Jamie215/HULC_motionshirt/firmware/MULTINODE_SYNC_MATH.md

# Multi-Node Sync & Reconciliation — Logic and Math

Companion to `MULTINODE_SYNC_DESIGN.md` (architecture/decisions). This document
records the **math and algorithm** behind time-aligning multiple IMU nodes, as
implemented in `tools/reconcile_nodes.py`. It is written so the method can be
reviewed, reproduced, and improved independently of the code.

> Equations use LaTeX (`$…$` inline, ` ```math ` display blocks), which renders
> on GitHub and in most Markdown viewers. Where a viewer does not render math,
> the symbols are still readable in source form.

---

## 1. The problem

Each node timestamps its samples with its own free-running `millis()` counter,
which starts at the node's power-on and ticks on its own crystal. For a physical
event at real time $\tau$, node $X$ records

```math
t_X(\tau) = \bigl(\tau - \text{boot}_X\bigr)\cdot 1000 \quad[\text{ms since node } X \text{ booted}]
```

Two nodes therefore disagree in two ways:

1. **Offset** — $\text{boot}_A \neq \text{boot}_B$, so their clocks have
   different origins.
2. **Drift (skew)** — their crystals tick at slightly different rates
   (tens of ppm), so the offset changes slowly over time.

"Reconciling" means finding, for each non-reference node $B$, a mapping onto the
reference node $A$'s timeline:

```math
t_{\text{on }A} = t_B + \text{offset} + \text{drift}\cdot\bigl(t_B - t_{B,0}\bigr) \quad (1)
```

where $\text{offset}$ (ms) and $\text{drift}$ (unitless rate, reported in ppm)
are what we must estimate. This is the **standard two-parameter clock model**
used by NTP, PTP, and distributed-systems clock synchronization.

The design constraint (see `MULTINODE_SYNC_DESIGN.md`): nodes are wireless and
analysis is offline, so we recover $\text{offset}/\text{drift}$ **from the
recorded motion itself**, independent of BLE latency.

---

> **Current default: the vector feature (§2.1).** Sections 2–4 describe the
> original angular-*speed* aligner, which is still the fallback
> (`--sync speed`). The default, `--sync vector`, correlates the full
> world-frame angular-velocity **vector** instead; §2.1 gives its math and
> acceptance rule. The offset/drift machinery (§3.1, §3.2, §5, §6) is shared.

## 2. The motion feature: angular speed (mounting-invariant)

Each node logs unit quaternions $q_i$ (orientation). Raw quaternions are **not**
comparable between nodes because each sensor is mounted at a different, unknown
orientation. So we reduce each stream to a scalar invariant to mounting:
**angular speed**, the magnitude of the rotation rate.

The rotation between consecutive orientations $q_i, q_{i+1}$ has angle

```math
\theta_i = 2\,\arccos\!\bigl(\lvert\, q_i \cdot q_{i+1}\,\rvert\bigr) \quad (2)
```

(the dot product is the quaternion inner product; the absolute value takes the
shorter arc, since $q$ and $-q$ are the same rotation). Angular speed is

```math
\omega_i = \frac{\theta_i}{\Delta t_i}, \qquad \Delta t_i = \frac{t_{i+1}-t_i}{1000} \quad (3)
```

**Why this works:** for a rigid body, angular velocity is a property of the body
(the same for every frame on it), so its magnitude $\lvert\omega\rvert$ is
identical regardless of how each sensor is bolted on. Two sensors on the same
moving segment therefore produce *correlated* angular-speed signals even though
their raw quaternions differ. (Implementation: `angular_speed()`.)

### 2.1 The default feature: world-frame angular-velocity vectors

Every node's Rotation Vector lives in the **same** world frame (gravity +
magnetic north), so the angular velocity can be expressed in that shared frame
rather than reduced to a magnitude. With $q_{i+1} = \Delta q_i \otimes q_i$,

```math
\Delta q_i = q_{i+1} \otimes q_i^{*}, \qquad
\boldsymbol\omega_i = \hat{\mathbf u}(\Delta q_i)\,\frac{2\arccos\lvert\Delta q_{i,w}\rvert}{\Delta t_i} \quad (3')
```

puts the increment in the world frame. A rigid segment has one world angular
velocity whatever its mounting, so two nodes that move together show the same
vector, **direction included** (`world_angular_velocity`). Each component is
resampled to the uniform grid and the three cross-correlations are summed, i.e.
the correlation of the vector signals is $\sum_k \boldsymbol\omega_A(k)\cdot\boldsymbol\omega_B(k+\ell)$.
The lag is the arg-max with the same parabolic refinement (§3.2).

**Acceptance.** Nodes on different segments (torso vs. arm) mostly move on their
own, so the overall normalised correlation $c$ (sum of dot products over the
overlap, divided by the two signals' norms) is low even when one shared sync
gesture pins the lag exactly. What matters is whether the best peak is
**distinct**:

```math
\rho = \frac{C(\hat\ell)}{\max_{\lvert \ell - \hat\ell\rvert > 0.5\,\text{s}} C(\ell)} \ \ge\ 1.25
\quad\text{and}\quad c \ge 0.10 \quad (9')
```

(`VECTOR_PEAK_RATIO_MIN`, `VECTOR_PEAK_EXCLUDE_S`, `VECTOR_CONFIDENCE_MIN`).
If either fails the aligner falls back to the speed method of §§2–4. The chosen
method and $\rho$ are written to `aligned.quality.json` as `sync_method` and
`sync_peak_ratio`. On synthetic torso + upper-arm sessions (`timing_bench.py`),
vector sync reaches the accuracy of a perfect-clock oracle where speed sync
failed.

---

## 3. Estimating the offset by cross-correlation

We have two angular-speed signals sampled at slightly different, jittered times.
Resample each onto a uniform grid at $f_s$ (default 100 Hz) in **relative** time
($t - t_0$), giving sequences $a[n]$ (node $A$) and $b[n]$ (node $B$) plus each
node's first timestamp $A_0, B_0$. (Implementation: `resample_uniform()`.)

The lag between the two sequences is found by **cross-correlation** (the classic
time-delay-estimation method):

```math
C[k] = \sum_n \bigl(a[n]-\bar a\bigr)\,\bigl(b[n-k]-\bar b\bigr) \quad (4)
```

```math
\hat k = \arg\max_k C[k], \qquad L = \frac{\hat k}{f_s}\ \ [\text{s}] \quad (5)
```

Positive $L$ means $a$ is delayed relative to $b$. (Implementation:
`_xcorr_full()` via FFT for $O(N\log N)$; `best_lag_seconds()` /
`lag_and_confidence()`.)

### 3.1 From relative-time lag to an absolute clock offset

The correlation is computed on **relative-time** signals, so $L$ alone is not
the clock offset — it must be combined with the difference of the nodes' start
timestamps. The two signals match when they sample the same real motion, i.e.

```math
\text{boot}_A + \frac{A_0 + s}{1000} \;=\; \text{boot}_B + \frac{B_0 + s - 1000L}{1000}
\quad \forall s
```

The $s$ terms cancel (a constant offset — the "no drift" case), leaving

```math
\bigl(\text{boot}_B - \text{boot}_A\bigr)\cdot 1000 \;=\; (A_0 - B_0) + 1000L
```

The left side is exactly the offset that maps $B$'s timestamps onto $A$'s clock
($t_A = t_B + \text{offset}$). Hence

```math
\boxed{\ \text{offset} = (A_0 - B_0) + 1000L \quad[\text{ms}]\ } \quad (6)
```

- $A_0 - B_0$ converts the relative-time result back to absolute clocks
  (bookkeeping).
- $L$ is the *measured* correction, read from the shared motion.

Equivalently, cross-correlating the two signals in **absolute** timestamps
directly yields $\text{offset}$; the code works in relative time only for
numerical convenience and adds $A_0 - B_0$ back.
(Implementation: `estimate_offset_drift()`.)

### 3.2 Sub-sample refinement (parabolic interpolation)

$C[k]$ is only evaluated at integer lags (10 ms apart at $f_s = 100$ Hz). The
true peak usually lies between samples, so we fit a parabola through the peak
sample and its two neighbours $y_{-1}, y_0, y_{+1}$
($= C[\hat k -1], C[\hat k], C[\hat k +1]$) and take its vertex:

```math
\delta = \tfrac{1}{2}\,\frac{y_{-1}-y_{+1}}{\,y_{-1}-2y_0+y_{+1}\,}, \qquad \delta\in[-\tfrac12,\tfrac12] \quad (7)
```

```math
L = \frac{\hat k + \delta}{f_s}
```

Near a smooth peak any function is locally quadratic (Taylor), so this is a
standard, well-justified refinement — it takes lag resolution from ~10 ms down
to ~1 ms. (Textbook DSP; used in spectral-peak and pitch estimation.)

---

## 4. Confidence — was there real shared motion?

$\arg\max$ always returns *a* peak, even for unrelated signals. So we separately
score whether the peak reflects genuine shared motion, using the **Pearson
correlation** of the two signals overlapped at the best lag:

```math
r = \mathrm{corr}\bigl(a_{\text{overlap}},\, b_{\text{overlap}}\bigr)\ \text{at lag }\hat k, \qquad r\in[-1,1] \quad (8)
```

Pearson is normalized (divided by each signal's standard deviation), so it
measures *shape* agreement independent of amplitude — a differently-swinging node
still scores high if it moved *together*. We accept the offset only when

```math
r \ge r_{\min} \quad (r_{\min} = 0.40) \quad (9)
```

Below that, the tool flags the result unreliable and the caller falls back to the
BLE clock-offset read and/or a start-of-session sync gesture.
(Implementation: `_pearson_at_lag()`.)

**Limitation this guards:** cross-correlation needs shared motion. Two nodes on
*independently* moving limbs (one arm swings, the other still) share nothing to
lock onto, and $r$ correctly drops toward 0. This is why a shared sync gesture is
the *primary* anchor and cross-correlation is a *refinement* (see
`MULTINODE_SYNC_DESIGN.md`).

---

## 5. Drift (clock skew) estimation

Drift is **off by default**: over a few-minute record, relative crystal drift is
only a few ms — below the measurement noise and negligible against the 25–50 ms
target — so fitting it adds noise. It is opt-in for long records.

When enabled, the lag is measured in $K$ windows spanning the record, giving
pairs $(t_j, L_j)$. A least-squares line $L = m\,t + c$ is fit; the slope $m$ is
the drift. It is accepted only if it is both statistically significant and large
enough to matter (the code constant `DRIFT_RESOLVE_MS` is written
$\varepsilon_{\min}$ below):

```math
\lvert m\rvert > 3\,\mathrm{SE}(m) \quad\text{AND}\quad \lvert m\rvert\cdot\bigl(t_{\text{last}}-t_{\text{first}}\bigr) > \varepsilon_{\min}\ (=15\text{ ms}) \quad (10)
```

Otherwise $\text{drift}=0$. Reported as `drift_ppm` $= m\times 10^6$.
(Implementation: `_windowed_lags()`, `_lsq_slope()`.)

Two guards keep the windowed lags honest (`_aligned_overlap`, `_windowed_lags`):
the windows are laid over the two nodes' **common** time span after applying
the global offset (so window $j$ of A and of B cover the same real time), and a
window is kept only if the two signals share motion in it (correlation
$\ge r_{\min}$). In a window where one node sits still, the "best" lag is
arbitrary; before this guard a trend fitted through such windows read a false
$+15.9$ s on a real capture. Fewer than 3 usable windows ⇒ no drift.

---

## 6. Applying the mapping and emitting aligned streams

With $\text{offset}$ (and optional $\text{drift}$), node $B$'s timestamps are
mapped onto $A$'s clock via Eq. (1) (`to_A_clock()`). A common uniform time grid
is built over the mutual overlap, and each node's **quaternions** are
interpolated onto it with normalized-linear interpolation (nlerp) along the
shorter arc:

```math
q(t) = \mathrm{normalize}\!\bigl((1-f)\,q_0 + f\,q_1\bigr), \qquad f = \frac{t - t_0}{t_1 - t_0} \quad (11)
```

(with a sign flip when $q_0\cdot q_1 < 0$). For 10 Hz human motion nlerp is
adequate; true SLERP could be substituted. The output is a CSV: one
`t_common_ms` column plus each node's $q_w,q_x,q_y,q_z$, ready for analysis.
(Implementation: `nlerp()`, `align_and_emit()`.)

---

## 7. Validation

`reconcile_nodes.py --selftest` generates two synthetic nodes from a shared
random motion with a **known** injected offset and drift, different mounting
rotations, sensor noise, and timing jitter, then checks recovery:

- recovered offset vs. the injected truth (target: within ~25–50 ms), and
- a **negative control** — a second node given *independent* motion must come
  back with low confidence and be flagged.

Current result: offset recovered to ~15–18 ms; shared-motion confidence
$r\approx 0.93$, independent-motion $r\approx 0.07$. This validates the *math* on
synthetic data; it is **not** a validation against hardware ground truth (§9).

---

## 8. Known limitations

- **Needs shared motion** (§4). Independent-limb captures require the sync
  gesture / BLE offset instead.
- **Linear clock model** (Eq. 1) — valid over minutes; a long session with
  temperature-driven crystal changes could need piecewise / periodic re-sync.
  See §11 for how a full-day capture is handled by tracking $\text{offset}(t)$
  as a fitted curve instead of a single global line.
- **Dropouts/gaps** in the logs degrade the correlation and inflate the residual
  (observed on real captures with intermittent recording).
- **Clock restarts.** A node that reboots mid-log (battery died) restarts
  `millis()` at 0, so one log holds two unrelated clocks. The loader splits at
  any backward jump over `CLOCK_RESET_MS` (1 s), keeps the largest segment,
  warns, and records `clock_restarts` in the quality JSON; the other pieces
  are not analysed. Offloading at every charge (one block per log) avoids it.
- **Speed fallback is a magnitude** — angular speed discards the rotation axis;
  two motions with identical speed profiles but different axes are
  indistinguishable to it. The default vector feature (§2.1) keeps the axis.

---

## 9. Algorithm / Technique Justification

The method is an assembly of **standard techniques** mentioned below:

- **Cross-correlation time-delay estimation** — the core. Classic reference:
  Knapp & Carter, *"The Generalized Correlation Method for Estimation of Time
  Delay,"* IEEE Trans. ASSP, 1976 (the GCC / GCC-PHAT foundation).
- **Aligning unsynchronized sensors by a shared signal** — standard practice in
  multi-camera/mocap/audio sync and multi-IMU synchronization (cross-correlate a
  common motion feature such as angular rate).
- **Offset + linear-skew clock model** — the standard model in NTP/PTP and
  sensor-network clock synchronization.
- **Parabolic peak interpolation** — textbook sub-sample estimation.

**Status:** Current implementation has **not** been benchmarked.

---

## 10. Upgrades for a rigorous / publishable result

1. **Ground-truth it** — feed a shared electrical sync pulse to a GPIO on all
   nodes, timestamp it in `millis()`, and report the *actual* alignment error in
   ms rather than a confidence score.
2. **GCC-PHAT** — whiten the cross-spectrum before the inverse FFT for a much
   sharper, more robust delay peak under noise and gaps.
3. **Robust fitting** — RANSAC or weighted least squares for offset/drift so
   dropouts don't skew the estimate.
4. **Richer feature** — correlate the full angular-velocity vector (rotated into
   a common frame after a coarse alignment) instead of only its magnitude, to
   break the axis-ambiguity of §8.

---

## 11. Long-session drift tracking: $\text{offset}(t)$ as a fitted curve

§5's single global line (one $\text{offset}$, one $\text{drift}$ for the whole
record) assumes the relative skew is **constant** across the capture. That holds
for a minutes-long record at stable temperature. It does **not** hold for a
full-day wear, where the skew itself drifts as body/ambient temperature moves the
crystals (§8). This section records the model that covers the long case, and
clarifies two points where the naming ("offset and drift") can mislead.

### 11.1 The model: one curve, sampled by events

There is a single underlying function

```math
\text{offset}(t) \quad [\text{ms}], \qquad \text{drift}(t) = \frac{d\,\text{offset}}{dt}
```

— the true clock difference between node $B$ and node $A$ at every instant, and
its local slope. Every shared-motion event (the don-time sync gesture of §3, or
incidental everyday motion, §11.2) is a **noisy sample** of this function:
cross-correlating the two nodes' motion windows (vector, or speed as fallback) around the event yields
one measurement $\bigl(t_j,\ \widehat{\text{offset}}_j\bigr)$ via Eq. (6), with a
confidence $r_j$ (Eq. 8). Reconciliation **reconstructs the curve** by
fitting/interpolating through these samples.

Two things the naming ("offset and drift") can obscure:

- **`offset` is absolute, not cumulative.** Each event measures
  $\text{offset}(t_j)$ directly and independently; you never add event $j{+}1$'s
  offset onto event $j$'s (that double-counts). The only thing that accumulates
  is *extrapolation error when you stop measuring* ($\approx
  \text{drift}\times\Delta t$) — the cost of a gap, not a property of the model.
- **`drift` is a slope, not a separate measurement.** It becomes observable only
  once samples are separated in time, which is why the don gesture (seconds long)
  gives a good `offset` but a poor `drift` — the lever arm is too short to clear
  the noise floor (`DRIFT_RESOLVE_MS`, Eq. 10). A single event's offset is noisy
  too, so you neither "trust it for $N$ minutes then jump" (which steps
  $\text{offset}(t)$ discontinuously and discards still-good samples) nor discard
  the prior estimate — you **fuse** (§11.2).

### 11.2 Getting the anchors, and combining them over time

**Where the samples come from.** They need not be deliberate. Over a day of wear
the body produces many **shared** events — standing up, starting to walk, turning
— each a fresh $\bigl(t_j, \widehat{\text{offset}}_j\bigr)$ measured by the *same*
machinery, with the confidence gate (Eq. 9) selecting which node-pairs each event
is valid for. Prefer **aperiodic transients** (sit→stand, turns); periodic motion
(steady walking) has the multi-peak lag ambiguity of §3/§4 and anchors poorly
even when shared. Participation is partial — an event re-anchors only the subset
of nodes that moved together, and different events cover different subsets, so
over a day it averages out. A node still for a long stretch isn't re-anchored, but
its signal is flat then, so the misalignment is harmless and *its next motion is
itself an anchoring event*.

**How the anchors combine.** There is no fixed validity duration; an old anchor
stays useful while its implied extrapolation error stays under budget, set by the
ratio of **process noise** (how fast $\text{drift}$ wanders — temperature
dynamics) to **measurement noise** (how tightly one event pins `offset`). Two
standard estimators carry $\bigl[\text{offset},\ \text{drift}\bigr]$ as a tracked
state rather than switching on a timer:

- **Sliding-window least squares** — fit a line to the $\bigl(t_j,
  \widehat{\text{offset}}_j\bigr)$ in a trailing window $W$, long enough for a
  good lever arm but short enough that drift is ~constant across it.
- **Kalman filter** — predict between events ($\text{offset}\mathrel{+}=
  \text{drift}\cdot\Delta t$; drift a slow random walk; covariance grows) and
  update at each event by the Kalman gain (confidence). Old data decays smoothly
  rather than being dropped, the process-noise parameter setting that forgetting
  time.

Either way a new event neither replaces nor adds to the prior estimate — the
estimate moves *partway* toward it, weighted by relative confidence. Drift moves
only with temperature, so anchors need not be frequent.

**Offline, most of this is moot.** "How long is a stale value good?" bites only
in real time, when all you have is the past. This pipeline is **post-hoc** — the
whole log is on the host at reconcile time — so for essentially any instant,
anchors bracket it on **both sides**. Evaluate $\text{offset}(t)$ by
**interpolating between the bracketing anchors** rather than extrapolating from a
stale one; the residual is far smaller. Extrapolation (and hence "validity
duration") only bites at the ends of the log, or inside a one-sided gap.

### 11.3 Where the code is, and the upgrade path

`reconcile_nodes.py` today fits the **single global line** of §5 — the simplest
point on this spectrum, correct for a minutes-long, stable-temperature capture.
Extending to full-day records means replacing that one line with the
**sliding-window fit or Kalman tracker** of §11.2, seeded by the don anchor and
fed by incidental events, then evaluated by interpolation. The per-event
measurement, confidence gate, and windowed-lag machinery all already exist
(`lag_and_confidence()`, `_windowed_lags()`, `_pearson_at_lag()`); what is new is
carrying `offset`/`drift` as a **tracked state over the whole log** instead of two
scalars. Robust fitting (§10.3) and GCC-PHAT (§10.2) compose with this directly —
they sharpen and de-weight the individual samples the tracker consumes.
