Jamie215/HULC_motionshirt/firmware/POWER_OPTIMIZATION.md

# Firmware Power Optimization

Power work on `firmware.ino`. This document tracks what has landed and 
the backlog of ideas still worth exploring, so nothing gets lost. Pre-optimization
baseline (from `IDLE_WAKE_SOURCE.md`): ~12 mA IDLE (DETECTOR), ~22 mA ACTIVE 
recording (full fusion).

## Landed

These are in the firmware now. None change the recorded data format or the state
machine's logic; each is commented at its site.

1. **DC/DC regulator enabled** — `NRF_POWER->DCDCEN = 1` at the top of `setup()`.
   Switches the nRF52840's main supply from the default LDO to the internal buck
   converter (the XIAO populates the REG1 inductor). More efficient in every
   state, most of all with the radio active. Board-wide; a large part of the
   measured idle and active drop (see Measured results).

2. **BLE advertising made cheap and IDLE-only.**
   - Advertising interval slowed to ~1 s (`ADV_INTERVAL_UNITS = 1600`, units of
     0.625 ms) — cuts advertising radio-on time ~10× vs the fast default. Offload
     is occasional and IDLE-only, so ~1 s discovery latency is fine.
   - Advertising is **gated to IDLE**: `applyPendingTransition()` re-advertises on
     IDLE entry and calls `stopAdvertise()` entering the RUNNING states; the
     disconnect handler only re-advertises when in IDLE. Offload is rejected
     outside IDLE anyway, so advertising while recording bought nothing and spent
     radio power at the IMU's peak draw.

3. **Report rate matched to log rate (Tier A).** `BNO_RV_INTERVAL_MS` 65 ms
   (~15 Hz) → 100 ms (10 Hz). The BNO no longer computes and ships ~5 fusion
   samples/sec that ACTIVE's `activeHz` gate discarded (each a wasted I²C read +
   nRF wake). Also drops STATIC_POSTURE (shared config, logs only 0.2 Hz) from
   ~15 Hz to 10 Hz. No change to recorded data.

4. **Game Rotation Vector A/B switch** — `ACTIVE_FUSION_SOURCE` (Section 3b),
   defaulting to `ACTIVE_FUSION_RV` so behavior is unchanged until flipped.
   `ACTIVE_FUSION_GRV` selects the 6-axis Game Rotation Vector (no magnetometer):
   no mag calibration, immune to magnetic interference from batteries / other
   on-body nodes / metal; the cost is slow yaw drift (pitch and roll stay solid).
   The 20-byte record format is identical, so nothing downstream changes.
   **Bench-measured: GRV gives no meaningful power saving vs RV** (see Measured
   results) — the gyro + fusion engine dominate, the magnetometer is cheap. So
   **decide GRV purely on data quality**, not power: keep the default RV unless a
   run of captured orientation data shows magnetometer-driven heading corruption
   (likely once multiple nodes + batteries sit close together on the body), in
   which case GRV trades absolute heading for cleaner, interference-free
   orientation. When building the GRV path, compile-check it against the installed
   SparkFun library version (the `getGameQuat*` getter names follow the current
   API but were not compiled here).

5. **External flash deep power-down during IDLE.** `qspiSleep()` puts the P25Q16H
   into deep power-down (`0xB9`) whenever the node sits in unconnected IDLE (which
   never touches flash); `qspiWake()` releases it (`0xAB`) before any access — on
   BLE connect (offload/erase arrive as control commands), at the top of
   `applyPendingTransition()` for the header write, and at end of `setup()`;
   re-park on IDLE entry and on disconnect back into IDLE. **Saving is small** —
   serial-NOR standby is ~tens of µA against the ~9 mA idle, below meter
   resolution — so don't expect the idle figure to move; this is completeness,
   not a lever.

   **Tried and reverted: nRF QSPI *peripheral* deactivation.** Also deactivating
   the nRF's QSPI peripheral (`nrfx_qspi_uninit()` on sleep, re-init on wake) was
   implemented and bench-tested, and it made idle **WORSE — ~9 mA → ~11 mA**.
   Cause: **nRF52840 Errata 122, "QSPI uses current after being disabled"** — a
   *disabled* QSPI peripheral leaks ~1–2 mA unless Nordic's errata workaround (an
   extra write to an undocumented power register) is applied, and the Seeed mbed
   core's nrfx does not apply it. So `nrfx_qspi_uninit()` handed us the leak, not
   a saving. **That code was removed** for readability; only the harmless chip
   deep-power-down above remains. If ever revisited, the peripheral disable must
   be paired with the Errata 122 register workaround and re-measured — but idle
   here is dominated by the BNO hub (~8 mA), so the ceiling on any QSPI-side win
   is small regardless.

6. **Tier B: STATIC-specific slow RV.** The RUNNING config is no longer shared
   at one rate — `configureBNO_Running()` now takes a `BnoRunningCfg`
   (`BNO_CFG_ACTIVE` / `BNO_CFG_STATIC`) and STATIC arms the fusion vector at
   `BNO_RV_STATIC_INTERVAL_MS` (1000 ms, ~1 Hz) instead of the ACTIVE 100 ms
   (~10 Hz). STATIC logs only 0.2 Hz, so even the Tier A 10 Hz RV shipped ~50
   reports per logged sample — each a wasted I²C read + nRF wake; ~1 Hz cuts
   those RV wakeups ~10× while still giving 5 orientation samples per logged
   snapshot (a logged posture is at most ~1 s stale, negligible for a static
   hold). **The Classifier is untouched — it keeps running at
   `ACTIVE_STABILITY_MS` (500 ms) in both RUNNING states, so it (not the RV)
   still drives every transition and motion detection out of STATIC is
   unchanged.** No change to the recorded data format or the 0.2 Hz log rate.

   Structural notes (this was the "needs careful validation" backlog item):
   - The old `bnoInRunningMode` bool couldn't tell an ACTIVE↔STATIC switch (rate
     must change) from a same-state re-entry (skip). It's replaced by the
     `BnoRunningCfg` enum (`NONE`/`ACTIVE`/`STATIC`), so same-state re-entry is
     still skipped, a fresh entry from IDLE / post-reset (`NONE`) enables *both*
     reports, and an ACTIVE↔STATIC switch re-issues *only* the fusion vector at
     the new rate — the fewest `enableReport`s, to stay off the command-buffer /
     premature-reset path (SparkFun issue #2). The `delay(50)` ack guard is kept.
   - The enum type lives in Section 10 (with `SystemState`), ahead of the first
     function, so the Arduino auto-generated prototype for the now-typed
     `configureBNO_Running(BnoRunningCfg)` sees it defined.
   - The classifier-floor point: because the Classifier still wakes the nRF at
     ~2 Hz in STATIC, the STATIC wake rate drops from ~12 Hz (10 RV + 2 clf) to
     ~3 Hz (1 RV + 2 clf) — a ~4× cut in nRF wakeups, not the full 10× the RV
     alone changes by. Taking the RV below the classifier's 2 Hz would buy little.

7. **IDLE wake source — DETECTOR (default), CLASSIFIER, SIGMOTION.** Three
   selectable wake sources (Section 3). Measured on the optimized build:

   | Source | Idle | Self-reset | Catches slow held-limb motion? |
   |---|---|---|---|
   | Stability Detector (default) | ~8.8 mA | ~6.7 s (benign) | Yes |
   | Significant Motion | ~7.4 mA | none | No — energetic motion only |
   | Stability Classifier | higher (gyro) | none | Yes |

   **DETECTOR is the default** because it reliably wakes on slow, deliberate
   motion (held-limb stretches). **SIGMOTION idles ~1.4 mA lower** — as a one-shot
   event it does not run the detector's ~6.7 s self-reset — **but it only fires on
   energetic motion (shake/pickup) and misses slow stretches** (it is an
   energy-over-a-window detector; its accel threshold + window are tunable via the
   FRS record `SIG_MOTION_DETECT_CONFIG` (0xC274) but the SparkFun library exposes
   no FRS-write path, so we cannot set it today — see `IDLE_WAKE_SOURCE.md`).
   So SIGMOTION suits only cases where slow-motion wake latency is acceptable
   (e.g. off-body standby), not on-body capture. CLASSIFIER also avoids the reset
   but runs the gyro/MotionEngine at higher idle current.

   The ~1.4 mA detector↔SIGMOTION gap is the self-reset cycle. That reset is
   inherent to a non-fusion continuous sensor, is unaffected by report rate, and
   is only removed by running the fusion engine (the classifier's cost) — so
   **~8.8 mA is the detector's floor for slow-motion capture**; going lower while
   keeping that capture needs a hardware wake (see the last backlog item). At the
   chip level the datasheet (Fig 6-18) puts the SIGMOTION sensor above the detector
   (~0.48 mA vs ~0.06 mA); SIGMOTION is still lower at the node level purely
   because it avoids the reset.

8. **Detector reported on-change (no ~1 Hz heartbeat).** The Stability Detector
   fires EXITED the instant motion breaks stability regardless of its report
   interval, so `IDLE_DETECTOR_INTERVAL_MS` is set long (60 s keepalive) and the
   detector stays silent while still instead of waking the nRF ~1×/s. Measured
   ~0.2 mA idle trim, with the ~6.7 s self-reset cadence and slow-motion
   sensitivity both unchanged. `handleIdle()` logs ms-since-last-reset as a field
   diagnostic of that cadence.

## Backlog — worth exploring

Ordered roughly by payoff. Each needs bench time or a design decision, so they
were deliberately left out of the safe batch above.

- **Reconfigure BNO rate on watermark throttle.** When flash fills,
  `writeQuaternionSample()` halves `activeHz` (10→5→2), but that only changes the
  software gate — the BNO keeps emitting 10 Hz, so the throttle saves flash but
  not IMU/nRF power. Reconfiguring the RV report rate when `activeHz` changes
  would capture the power saving too. Now cheaper to do safely: Landed item 6
  (Tier B) added the per-transition fusion-only reconfigure path
  (`configureBNO_Running(BnoRunningCfg)`), so this could re-issue just the fusion
  vector at the throttled rate the same way (mind the same SparkFun issue #2
  re-issue caution).

- **QSPI peripheral deactivation — tried, backfired, removed (see item 5).**
  Measured ~9 → ~11 mA idle from nRF52840 Errata 122; the code was removed. Only
  worth revisiting with the Errata 122 register workaround applied after the
  disable, and even then the BNO-dominated idle caps the win — low priority.

- **Sleep instead of spin while connected-idle.** In `waitForIMUData()`, the
  BLE-connected branch busy-loops on `BLE.poll()` for up to 100 ms with no sleep,
  so the core never idles while a central is connected. A `__WFE()` between polls
  would let it sleep between radio/BNO events. Relatedly, the fast 15–30 ms
  connection interval is held for the whole connection but only needed during
  offload — relaxing it except around a transfer cuts connected-idle radio
  wakeups.

- **Production build: drop USB/serial.** `DEBUG_SERIAL 1` keeps USB CDC (and
  HFCLK) alive. Note the `Serial.print`/`Serial.begin` calls in the QSPI helpers
  and `setup()` are **not** behind the macro, so `DEBUG_SERIAL 0` alone doesn't
  fully shed USB. Gate those too for a deployed build to remove the USB draw.

- **fsync tuning.** `FSYNC_EVERY = 10` does a 4 KB sector erase + write + readback
  every ~1 s at 10 Hz — erases are power-hungry and wear flash. Raising it trades
  a little more data-at-risk on power cut for fewer erases; the readback verify
  could also be made less frequent.

- **LEDs (hardware).** The SparkFun BNO086 breakout's red LED and the XIAO
  nRF52840's own power LED are **power indicators wired to the 3.3 V rail, not
  GPIOs** — not firmware-controllable. Disable by cutting the board's `LED`
  solder jumper (per node, reversible). ~1–3 mA each, on 24/7. Worth doing on
  every deployed node. In firmware, the blue "connected" LED (`PIN_LED_BLUE`) is
  held on for the whole connection — could be dropped or briefly blinked during
  long offloads.

- **Below the detector's slow-motion floor needs hardware.** With the detector
  (the only wake source that catches slow held-limb motion), idle floors at
  ~8.8 mA — the remaining ~1.4 mA to SIGMOTION's ~7.4 mA is the detector's
  inherent ~6.7 s self-reset, which only running the fusion engine removes (at
  higher current) and which no report-rate change affects. Going lower while
  keeping slow-motion capture would need a separate low-power motion sensor with
  its own interrupt waking the nRF, which then powers the BNO — a hardware change,
  out of scope for firmware alone.
