Jamie215/HULC_motionshirt/hardware/HULC_MS_Wearable_Case.step

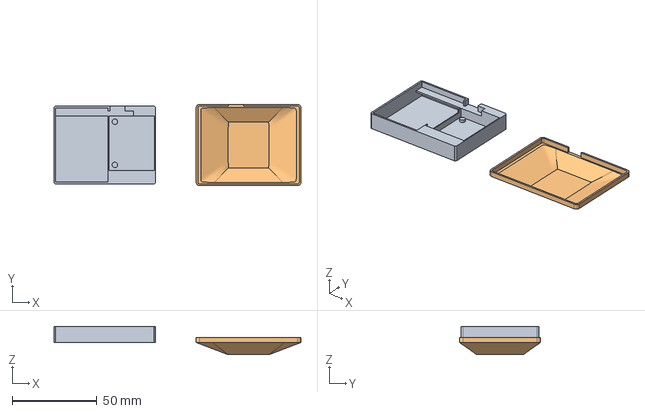
[picture p9: CAD file, 2026-10-29]
hardware/HULC_MS_Wearable_Case.step
146.0 x 48.0 x 16.7 mm
