Jamie215/HULC_motionshirt/firmware/MULTINODE_TESTING.md

# Multi-Node BLE Sync Testing

This document covers testing the **synced BLE connection across multiple IMU
nodes** — the step after the single-node Phase 3e firmware. A motion shirt uses
several IMUs (one per body segment); their quaternion streams are only fusable
if all nodes share a common time base to within a few milliseconds.

## What changed in the firmware for multi-node

| Change | Where | Why |
|---|---|---|
| **Unique per-board name** `HULC-IMU-XXXX` | `makeDeviceName()` | All boards used to advertise `HULC-IMU-01` and collide. The suffix is the last 4 hex chars of the board's BLE MAC, so it is stable per board with no per-board reflash (and needs no nRF MDK headers). |
| **Millisecond time sync** (control cmd `0x05`) | `handleControl()` | The legacy sync (`0x02`) carried a whole-**second** epoch — far too coarse to align nodes. `0x05` carries a `uint64` epoch in **ms**. |
| **Time Info characteristic** `A005` (read, 16 B) | `updateSyncInfo()` / `onSyncInfoRead()` | Lets the central read each node's live clock and reconstruct its epoch-now, so cross-node offset can be measured. Refreshed on every read. |
| **Fast connection interval** (7.5–15 ms) | `setup()` `BLE.setConnectionInterval(6,12)` | The first 2-node run showed A005 reads taking 300–800 ms, which floored offset measurement. Requesting a tight interval drops GATT read latency so the offset becomes meaningful. The central may clamp it — it is a request, not a guarantee. |

The legacy `0x02` (seconds) command still works and now also populates the ms
mapping, so nothing downstream breaks.

### A005 layout (little-endian)

| Bytes | Type | Field |
|---|---|---|
| 0–3 | uint32 | node `millis()` at the moment of the read (live) |
| 4–11 | uint64 | sync epoch in ms (0 if never synced) |
| 12–15 | uint32 | node `millis()` captured at the last sync |

The central computes each node's current epoch as:

```
node_epoch_now_ms = sync_epoch_ms + (node_millis_now - sync_millis)
```

and compares two nodes to get their clock offset (the host term cancels).

## Test setup (laptop harness, 2 boards)

1. Flash the firmware to **both** XIAO nRF52840 boards from `firmware/firmware.ino`.
   No per-board edits — each derives its own name from its BLE MAC.
2. Power both boards. Confirm over serial that each prints a **distinct**
   `[BLE] Advertising as HULC-IMU-XXXX`.
3. On the laptop:
   ```bash
   pip install bleak
   python tools/multinode_test.py check --count 2 --duration 60
   ```

The harness scans, connects to both nodes simultaneously, syncs each with an
ms-resolution timestamp, then reads `A005` from both in a round-robin for the
duration and reports the cross-node offset and its drift.

The tool uses subcommands (`check`, `erase`, `offload`, `enroll`,
`read-segments`, `selftest`); the older flag form (`--offload`, `--erase`, …)
was retired.

Other modes:
* `check --count 1` — single-node latency diagnostic (isolates per-link latency
  from multi-connection scheduling).
* `offload` — offload each node's flash log to a `.bin` (and measure throughput
  KB/s), with a `.seg.json` segment sidecar per node and the block's
  `montage.json` built from them. The transfer is now framed and loss-verified —
  see below.
* `enroll --segments ...` — map each board to a body segment (power one node at a
  time) and write `montage.json`; see `docs/COLLECTION_REFERENCE.md` §4.

## Flash offload — framing & drop recovery

(The protocol a central follows — commands, framing, recovery — is written out
for a mobile app in `docs/BLE_PROTOCOL.md`.)

The offload streams the flash log over the `A004` characteristic as BLE
**notifications**, which are **unacknowledged**: if the central's stack drops
one (common on Windows/WinRT under a fast burst), that packet is gone and
neither side is told. Because each packet carried 10 back-to-back records
(200 bytes ÷ 20), a single dropped notification silently deletes a 10-record
run from the *middle* of the reconstructed file, and the records on either side
become adjacent — showing up downstream as a multi-second **gap** with clean,
valid records on both sides. The tell: gap durations are exact multiples of one
chunk (~1.2 s = 10 records), independent per node, with nothing in the device's
serial (the recording never gapped — only the transfer lost data).

To make loss **detectable and recoverable**, every notification is framed:

| Bytes | Field |
|---|---|
| 0–3 | `uint32` LE **offset** of this payload within the log data region |
| 4… | up to `OFFLOAD_DATA_SIZE` (196) bytes of record data |

A **header** notification is sent first with a sentinel offset
(`0xFFFFFFFF`) whose payload is the exact total log length. Framing stays within
the existing 200-byte notification, so no MTU change is needed.

The host (`measure_offload`) places each payload by its offset, so a dropped
notification leaves a **locatable hole** instead of a collapsed gap. Recovery
has two parts, both leaning on the fact that the node does **not** erase until it
receives `0x03`:

1. **Backpressure (firmware).** `offloadChar.writeValue()` returns false when the
   BLE TX buffer is full; the sender now retries the same notification (pumping
   `BLE.poll()`) instead of advancing, so it self-paces to the negotiated
   connection interval rather than blasting every 3 ms and overflowing. Without
   this the sender alone dropped ~45% of notifications.
2. **Targeted range re-request (control `0x06`).** After a first full pass
   (which also delivers the header total), the host re-requests **only the
   missing byte ranges** — `[0x06, offset u32 LE, length u32 LE]` → the firmware
   re-sends just those bytes with the same framing. A whole-log re-offload
   recreates the same fast burst and tends to drop the *same* chunk every pass
   (deterministic central-side loss that merging can never fill); a small,
   non-bursty range resend does not, so it recovers those holes. Repeats up to
   `OFFLOAD_MAX_ATTEMPTS` (4) times until the bytes match the header total.

Reading the output:

* `pass 1 (full): 3528/5300 bytes, 5 hole(s)` → drops detected and located.
* `pass 2: re-requesting 5 range(s)...` → targeted recovery.
* `COMPLETE — saved N bytes (M records) -> file.bin` → verified whole; safe to
  reconcile.
* `[!] INCOMPLETE after 4 attempts …` → still missing after all retries. The
  file is saved with holes **zero-filled** (reconcile drops zero-norm records,
  so survivors keep their true timestamps rather than collapsing into a fake,
  undetectable gap), and a warning lists the missing offsets. Re-run `offload`
  to recover the rest (the log is still on the node).

If a particular central drops heavily, raise `OFFLOAD_MAX_ATTEMPTS`, or switch
to a non-Windows central (below) — the same platform choice that governs
throughput also governs drop rate.

### Flash hygiene — erase between sessions

The write pointer persists across reboots (it's saved in the flash header), so
if you **power-cycle a node without erasing**, the next recording is *appended*
to the old one. `millis()` resets to ~0 on boot, so the log then holds two
sessions with a large backward timestamp jump at the seam. `reconcile_nodes.py`
keeps the strictly-increasing run and drops the rest — you'll see a
`dropped N/M bad records (… non-monotonic)` warning. It's harmless to the
analysis but means stale data is accumulating.

Keep each node's flash to a single session:

* **`offload --erase-after`** — wipe each node's flash **only after its
  offload is verified `COMPLETE`**, so you never erase data you didn't fully
  receive. This is the clean default workflow: offload, verify, wipe.
* **`erase`** — wipe each node that holds data (`--yes` skips the per-node
  confirm), then exit (use before a capture, or to
  clear a node you don't need to offload).

`eraseLog()` erases the whole chip in 64 KB blocks and **verifies the data region
reads back blank (0xFF) before resetting the write pointer**, so a silently
failed erase leaves the log intact and still reported at its real size rather
than falsely showing `log=0KB`.

## Offline reconciliation (`tools/reconcile_nodes.py`)

Aligns the offloaded per-node quaternion logs onto one common timeline by
cross-correlating the motion itself (world-frame angular-velocity vectors by
default, `--sync speed` for the older angular-speed method), so it recovers the
clock offset from the data — no dependence on BLE read latency. This is the
production sync path (see `MULTINODE_SYNC_DESIGN.md`).

```bash
pip install numpy
python tools/reconcile_nodes.py --selftest          # validate the math, no HW
python tools/reconcile_nodes.py A.bin B.bin --out aligned.csv   # real logs
```

The `--selftest` recovers a known injected offset to ~15–18 ms (inside the
25–50 ms target). For real use, offload each node's log to a file of raw 20-byte
records and pass them in node order (the first is the reference clock).

**Central platform matters.** A slow negotiated connection interval floors both
read latency and offload throughput. Desktop Windows (via `bleak`) tends to
impose a slow interval; iOS/BlueZ honor the firmware's 15–30 ms request.
Testing from a non-Windows central:
* **iPhone** (*nRF Connect for Mobile*) — iOS hides the connection interval from
  apps, so judge it by *behavior*: enable notifications on `A004`, write `04` to
  the Control char `A002` to start the offload, then **read the node's USB
  serial monitor** for the `[OFFLOAD] Done` line. The firmware measures the real
  wall-clock transfer time and prints throughput (KB/s) and **ms/chunk** — and
  because one notification goes out per connection event, ms/chunk ≈ the
  effective connection interval the central negotiated (the number iOS won't
  tell you directly). This is the most reliable way to measure offload speed on
  any central.
* **Mac** — run `multinode_test.py offload` (`bleak` works over CoreBluetooth)
  for a hard KB/s number, directly comparable to the Windows run.
* **Android** nRF Connect *does* display the negotiated interval directly.

See `MULTINODE_SYNC_DESIGN.md` for the full rationale.

## How to read the results

* **CONNECT** — both nodes should report connected and *stay* connected. A node
  that is connected no longer advertises; if the harness can't find the second
  node, make sure it isn't already connected to something else (e.g. a phone).
* **read window** (per node) — how long each `A005` read took round-trip. This
  is the **measurement floor**: the node's clock is only known to within its
  read window. Bench observation is ~300–800 ms with two simultaneous
  connections, because the firmware services BLE in ~100 ms bursts in IDLE
  (`waitForIMUData`) and does not request a fast connection interval. Until this
  drops, offset cannot be measured to better than a few hundred ms.
* **offset** — reported as a value **± the read-window bound**. Treat it as an
  *upper bound* on the true offset, not a calibrated number. A result like
  "±300 ms" means only that the nodes are aligned to within a few hundred ms —
  it does **not** confirm ms-level sync.
* **drift** — the harness prints `NOT RESOLVABLE` whenever the measured slope is
  below the read-latency noise floor. Real relative crystal drift between two
  nRF52840s is tens of ppm → single-digit ms/min, which is far below that floor,
  so a large or negative "drift" from a noisy run is a **measurement artifact**,
  not physical clock behavior.

**Bottom line:** this method validates *connectivity and the sync path*, but the
BLE read latency makes it unable to confirm ms-level alignment. For that, reduce
the read latency (firmware: fast connection interval + continuous BLE servicing
when connected) and/or use a shared physical event (below).

## Known limitations / next steps

* **Sync precision is bounded by BLE write latency.** `0x05` is issued per node
  over its own connection, so each node's sync moment carries that node's write
  latency (a few ms, variable). For tighter alignment consider: a round-trip
  (NTP-style) estimate that measures and subtracts the one-way delay, or
  periodic re-sync to cancel accumulated drift.
* **No shared physical event yet.** The offset here is a software estimate. To
  ground-truth it, tap all nodes together (a shared impulse in the accel data)
  and compare the recorded timestamps of that event across nodes.
* **Connection count.** Two nodes is the current bench target; the nRF SoftDevice
  and the host adapter both cap simultaneous connections — validate the real
  ceiling before scaling to a full-shirt node count.
