Jamie215/HULC_motionshirt/tools/SETUP_AND_CALIBRATION_PLAN.md

# Setup & Calibration — Design Plan (pipeline stages 5–7)

Planning doc for the later stages of the analysis pipeline, and the record of the
design decisions behind them. Stages 1–4 (capture → offload → reconcile →
montage/resolve) exist in `firmware/` and `tools/`; **stage 5 (calibration) is now
built** — `calibrate_segments.py` implements §4 below (the sensor→segment solve
with the cache-and-verify contract). This doc covers stage 5 and what still comes
after, in build order:

- **§2 Configuration & node identity** — how a node knows/records where it is.
- **§3 Time offset vs. mounting calibration** — two different quantities, two
  different lifetimes. The single most important distinction here.
- **§4 Calibration (stage 5)** — the sensor→segment solve, cache-and-verify.
- **§5 Free-body diagram (part of stage 7)** — the natural visual payoff.

See `pipeline_walkthrough.html` for the whole pipeline at a glance, and
`MONTAGE_SCHEMA.md` for the montage/resolver already built.

---

## 1. Anchor facts (from the firmware, not assumptions)

- Nodes log the **full Rotation Vector** (`enableRotationVector()` → report
  `0x05`), which is **magnetometer-referenced**. Every node's orientation is
  therefore already in a **shared world frame** (gravity + magnetic north), not
  the arbitrary per-node heading a Game Rotation Vector would give.
- Each sample is timestamped with the node's free-running **`millis()`**, which
  starts at zero on **power-up**. There is no persistent real-time clock.
- Nodes advertise a unique identity `HULC-IMU-XXXX` (from the BLE MAC); the
  offloaded file is named by it.

These three facts drive everything below.

---

## 2. Configuration & node identity

**Decision: separate "which node is where" (config) from "how the sensor sits on
the bone" (calibration).** They have different lifetimes (config is stable across
wears if sensors live in fixed garment pockets; calibration is per-don), so they
are different artifacts, not one step.

### 2.1 Persist the segment assignment on the node

> **Built.** `firmware/firmware.ino` stores the segment as a 1-byte code plus a
> config-valid tag in the log header's reserved bytes (persists across power
> cycles and log erases); it is set over BLE with control `0x07` and reported on
> the status characteristic. The code enum is pinned in
> `motion_capabilities.SEGMENT_CODES` (the one source of truth). Host side:
> `multinode_test.py` `set_segment` / `read-segments`, the `.seg.json` offload
> sidecar, and the `analyze_session` disagreement warning.

**Decision: store the segment as a 1-byte enum in a per-log *header*, not per
record, and not as a string.**

- Per-record would waste flash; a single header field per session is negligible
  against a 2 MB flash of 20-byte records. The "abbreviate to save space" worry
  only existed under a per-record assumption.
- A `uint8` segment code (`0=torso, 1=upper_arm_l, 2=upper_arm_r, …`) costs one
  byte. It makes the **offloaded file self-describing** — the file already says
  *which node*; the header adds *which body part* — which removes the
  mislabel-after-offload risk.
- Source-of-truth rule: the node header is the **default**, a host montage may
  **override**, and reconcile **warns on disagreement** (same pattern as the
  landmark check). Better: **auto-populate the montage from the headers** so it
  stops being hand-typed and the user only confirms.

### 2.2 The configuration stage (front end of montage + calibration)

The montage **is** the configuration; the config stage is the setup UX that
produces it. Fold three things into one "don the shirt" flow:

1. **Assign** each node to a location (writes/confirms the montage; may write the
   assignment to the node per §2.1).
2. **Verify placement** live via the free-body diagram (§5) — a mislabeled or
   slipped node is visible immediately.
3. **Calibrate** — strike the neutral pose (§4).

**Optional upgrade — auto-assignment.** Because nodes report absolute
orientation, a scripted setup ("raise your right arm") can detect *which node
moved* and assign it automatically, turning the error-prone manual mapping into
confirmation. Prototype after the manual path works.

### 2.3 Constrained, repeatable placement (why it helps)

**The mounting offset does not need the sensor aligned to anatomy — only placed
the same way each wear.** Two consequences worth designing the garment around:

- **Anatomical tilt is absorbed, not fought.** A chest node lies flat on the
  sternum, which slopes back with the ribcage, so it sits at a fixed angle to the
  true trunk axis. That fixed angle *is* the mounting offset — the neutral pose
  defines it away. The same holds for any arm node. So placement need not be
  "aligned"; it needs to be **repeatable**, because a repeatable offset is what
  lets `verify` reuse a cached calibration instead of re-posing every don (this is
  the "better mounting" rung of the §4 ladder).
- **Control the axial roll.** The most fragile degree of freedom for an arm node
  is rotation *around* the limb (it corrupts pronation/supination and int/ext
  rotation — see the elbow caveat in `MONTAGE_SCHEMA.md` §3). Fixing each arm
  sensor to a consistent flat spot (e.g. a sagittal-plane pocket referenced to a
  bony landmark, not just "somewhere on the segment") pins that roll down; the
  neutral pose then handles the two easier tilt axes. This constrains placement
  but **does not change the solve** — it just makes it better-conditioned and more
  repeatable, so keep solving all three axes rather than hard-coding any.

---

## 3. Time offset vs. mounting calibration (the key distinction)

Two quantities are refreshed at the start of a wear. They are **independent** and
must not be conflated:

| | Aligns | Invalidated by | Cacheable? | Refreshed how |
|---|---|---|---|---|
| **Time offset** | the nodes' clocks (temporal) | every **power-up** | **No** | automatic BLE clock read at connect, or a shared sync gesture |
| **Mounting calibration** | sensor→segment (spatial) | every **re-don** | **Yes** | a ~2 s neutral pose, or reuse-if-verified |

- **Time offset cannot be cached.** Each node's `millis()` restarts at zero on
  boot, so a previous session's offset is meaningless after a power cycle. It is
  re-anchored every session — but on a well-behaved central this is *automatic*
  (the BLE clock-offset read needs no user action). Within a session it holds
  (drift negligible over minutes).
- **Mounting calibration survives a power cycle** (it is a physical relationship,
  not a clock) and is broken only by physically re-wearing the garment — so it
  *can* be cached and verified.
- A charge-then-rewear trips **both**, for different reasons (the power cycle
  resets clocks; the re-don shifts straps). That coincidence is why bundling them
  into one session-start step is convenient — not extra burden, since the
  session-start moment already exists for timing.

**Correction this supersedes:** the sync gesture is per-*session*, not
once-forever. "Once at the beginning" means the beginning of each wear/session,
because power-up resets the clocks.

---

## 4. Calibration (stage 5) — the sensor→segment solve

> **Built:** `calibrate_segments.py` (`calibrate` / `verify` / `selftest`). It
> reads the reconcile `aligned.csv` + a montage, solves the per-segment mounting
> offset over the neutral-pose window, and emits `calibration.json` with the
> consistency baseline. `verify` runs the reuse-vs-re-pose check below against a
> cached calibration. Anatomy (segments, joint adjacency) is imported from
> `motion_capabilities.py` so there is one body model.

**In plain terms.** A sensor is like a compass strapped to the arm at some unknown
angle: it always reports honestly in a fixed world frame (gravity + magnetic
north), but a crooked strap means its reading is not yet *about the bone*. The one
unknown is that crookedness — the fixed rotation between sensor and bone. To find
it, we use a pose whose answer we already know: the subject stands in the neutral
pose, we declare that configuration to be zero, and whatever the sensor reads there
*is* the correction. Store it once; subtract it from every later reading, and the
numbers become anatomical. A joint angle is then just one corrected sensor relative
to its neighbour (upper-arm vs. torso = shoulder), which reads zero at the neutral
pose as it should.

**What it computes:** the mounting offset for each node — the rotation from the
sensor's frame to its segment's anatomical frame. The mag-referenced world frame
is *given*, so this is a sensor-to-segment calibration, **not** a "resting
quaternion" capture. See `MONTAGE_SCHEMA.md` §4 for the three jobs the neutral
pose does (solve offset, set zero, heading co-registration fallback).

**Cache-and-verify contract (decided).** The stage-5 routine emits **both**:

1. the per-segment mounting offset (→ `calibration.json`), and
2. a **staleness / consistency check** — enough to decide, on the next don,
   *reuse vs. re-pose*: during the first still moment, test whether the cached
   offsets are still self-consistent in the shared world frame (e.g. calibrated
   segment axes still point where a quiet-standing pose implies). Small residual
   → reuse silently; over threshold → prompt for a fresh ~2 s pose. The same
   check catches **intra-session slippage**, not just re-dons.

**Cheapening ladder** (build 1–2 first; 3–4 later):

1. **Fold into the session-start move** you already do for timing — the pose *is*
   the calibration, not a separate chore.
2. **Cache + verify** (above) — the "feels like skipping" path.
3. **Functional / auto-calibration from motion** — recover the offset from a
   short bout of ordinary movement (gravity gives vertical; a joint's gyro axis
   gives the hinge), removing the deliberate pose. More algorithm; needs each
   joint to move.
4. **Better mounting** (rigid, anatomically-shaped pockets) shrinks don-to-don
   variation, widening how often #2 can reuse before a re-pose.

**Emits:** `calibration.json` — per-segment offset + captured window + the
consistency baseline. Gates every angle/ROM metric; flips the resolver's
`calibrated` flags from relative-only to clinical.

---

## 5. Free-body diagram (part of stage 7) — feasibility

> **Built (`skeleton_viewer.py`, `render` / `selftest`).** Bakes the reconcile
> stream + an optional `calibration.json` into a single self-contained HTML
> viewer (no external scripts/CDN — a hand-rolled Canvas-2D 3-D renderer, works
> offline and straight from `file://`), with a **raw↔calibrated toggle**
> (applies `q_seg = q_WS ⊗ q_SB` in the viewer) and **jump-to-neutral**. (An
> earlier *Floating* layout — each segment an oriented bar at a fixed slot — was
> removed as confusing; the skeleton covers every montage.)
> - **Skeleton** — the orientations connected into a stickman by forward
>   kinematics (chain tier). The connectivity is the montage's kinematic chain
>   (imported from `motion_capabilities.JOINTS`); only the bone **lengths and
>   joint offsets** are assumed anatomy (the viewer's `ANAT` table). Missing
>   nodes degrade gracefully and stay honest: a missing *middle* segment (e.g.
>   torso + forearm, no upper arm) is drawn as a dashed "ghost" at rest hung
>   from the nearest measured joint, with the measured descendant attached to
>   its end; with no torso but both arms, each roots at a nominal shoulder and a
>   fixed dashed girdle labeled "torso — not measured" bridges them; an
>   **uncalibrated** bone draws with an amber "· raw" overlay so a kink there
>   reads as strap tilt, not motion.
> - **Facing** — the mag-referenced world gives orientation, not how the
>   subject's forward lines up with north, so a forward reach could draw
>   sideways. Calibration recovers the facing from the torso
>   (`compute_heading`, one coarse chest-mounting assumption, self-checked) and
>   the viewer applies it as a fixed yaw — **zero extra burden at capture**. No
>   torso, or a low-confidence check → facing left nominal, honestly labeled
>   (`--facing-deg` states it by hand).
> - **Front** — the shoulders sit on the subject's left/right from that facing, a
>   ground arrow marks FRONT (BACK / L / R around it), the chest face is lighter
>   and the head has a nose; Front / Side / Top buttons snap the camera. Unknown
>   facing → a dashed "front?" arrow.
> - **Forearm rotation** — limb boxes roll with the measured twist; forearm and
>   hand are flat with a lighter palm face and a thumb nub, and a corner panel
>   reads the live angles of every joint (same math as `metrics.py`, checked to
>   within 0.005° per sample). Playback runs at 1× / 2× / 5×.
> - **Trust at a glance** — header chips for calibration, front direction,
>   and sensor sync (from reconcile's `aligned.quality.json`), with per-card
>   warnings on joints / timing comparisons that depend on a low-sync sensor. Right side drawn warm, left cool; labels appear on hover or
>   with the Labels toggle.
> - **Angle over time** — click a movement in the metrics panel to graph it
>   across the session (other side dashed for comparison), playhead synced,
>   click/drag to seek; matches `metrics.py` per sample.
>
> The quaternion math, CSV binding, and body model come from the existing tools.

The most feasible visual, because **orientation is exactly what is measured** — a
quaternion per segment per frame directly drives an oriented 3-D body. It maps
one-to-one onto the resolver's tiers:

- **Segment tier (1 node)** → each segment drawn as its own oriented bone,
  hung at its nominal place in the skeleton. Needs only the orientation.
  Validates stages 5–6: jump to the neutral window and flip the raw↔calibrated
  toggle; if calibration worked the crooked limbs hang straight.
- **Joint tier (2 adjacent nodes)** → connect them at the joint. The **Skeleton**
  layout draws the linkage; the per-DOF angle read-out (from the resolver's
  decomposition) is the remaining piece, and belongs with the ROM metric plugin.
- **Chain (torso→arm→forearm→hand)** → a connected skeleton via forward
  kinematics (the **Skeleton** layout): root the torso, place each segment's
  proximal end at its parent's joint, orient by the quaternion, step down.

**The honest caveat, kept visible in the UI:** orientation is measured;
**position/connection is modeled**. The skeleton's connectivity is real (the
montage), but its **segment lengths and joint offsets are assumed** — so the two
layouts are one toggle apart, and the modeled positions never masquerade as
measured (orphan bones without a placed parent render dashed). Without
calibration the skeleton still renders but won't sit anatomically — which is
useful: **the neutral pose is how you *see* whether calibration worked.**

---

## 6. Build order

1. ~~**Stage 5 calibration** with the cache-and-verify contract (§4)~~ — **done**
   (`calibrate_segments.py`). The gate for every clinical angle.
2. ~~**Floating-segment FBD** (§5, segment tier) — validates §1 visually, cheap.~~
   — **done** (`skeleton_viewer.py`). Self-contained HTML viewer with the
   raw↔calibrated toggle; the neutral pose is where you *see* the mounting
   scatter collapse.
2b. ~~**Connected skeleton** (§5, chain tier) — forward kinematics over the same
   stream.~~ — **done** (`skeleton_viewer.py` **Skeleton** layout). Real kinematic
   chain + assumed lengths; pulled forward from step 5 because it's the same
   viewer and the intuitive read of the calibrated stream.
3. ~~**Firmware node header** (§2.1) + config-stage UX (§2.2) — self-describing
   logs, montage auto-populated.~~ — **done**. The node stores its segment as a
   1-byte code in the log header (config tag + code in the reserved header bytes),
   set over BLE (control `0x07`) and read back on the status characteristic.
   `enroll` now does it on one connection per node — smart-erase **and** stamp the
   segment — and `read-segments` builds a montage from the nodes' own headers (the
   §2.2 "user only confirms" flow). Offload drops a `<node_id>.seg.json` sidecar so
   captures are self-describing on disk; `analyze_session` warns when a node's
   header disagrees with the montage (montage stays authoritative).
4. ~~**Metric plugins** (stage 6) over the calibrated stream — ROM first, then the
   rest already declared by the resolver. The skeleton linkage exists; the
   per-DOF joint-angle read-out rides along with ROM (same decomposition).~~ —
   **done** (`metrics.py` `compute` / `selftest`). For every *computable* joint
   (via `motion_capabilities.resolve`) it applies the cached mounting offsets
   (`q_seg = q_WS ⊗ q_SB`), forms the distal-relative-to-proximal quaternion,
   re-expresses it in the anatomical frame from calibration (X anterior, Y
   superior, Z right — built from the facing), and decomposes it in the joint's
   declared ISB/Wu sequence — reading the exact slot
   each clinical DOF occupies from the new `DOF.seq_index` on the body model (one
   source of truth; a 2-DOF joint drops the unused slot). Emits per-DOF **ROM**
   (min/max/range/median), the peak angular velocity, and calibration-free
   segment angular speed. A joint whose two nodes aren't both calibrated, or
   with no anatomical frame (no confident facing), is flagged `clinical: false` (relative-only, same wording as the resolver); a
   blocked joint is reported blocked with the missing node named, never
   fabricated. Angles are unwrapped before ROM so a sweep past ±180° reports its
   true excursion. Wired into `analyze_session` as stage 4/5 (`metrics.json`),
   ahead of render so the stage-7 review can bake the metrics panel.
   The remaining declared metrics now ship alongside ROM in the same tool: joint
   angular **velocity** (peak/mean/RMS) and **rep counting** (hysteretic midline
   crossings, calibration-free); segment **angular travel** + active-time
   fraction, **elevation** from vertical, **smoothness** (SPARC spectral arc
   length), and a **posture-dwell** histogram (calibration-gated); and the full
   **derived** tier the resolver unlocks — L/R ROM **symmetry**, bilateral
   **activity asymmetry**, inter-joint **coordination** (cross-correlation +
   lag), and trunk **compensation**. Each derived metric is emitted only when
   `resolve()` says the montage supports it, and carries the same
   clinical/relative-only honesty flag. Every metric's formula, units, and
   calibration gate are catalogued in `METRICS.md`.
5. ~~**Full interface** (stage 7) — the metrics + the 3-D view in one review
   UI.~~ — **done**. `skeleton_viewer.py render` now takes `--metrics metrics.json`
   and bakes a review panel beside the 3-D body: per-joint **ROM** bars
   (range + min…max), peak/mean **velocity**, **rep** counts, the **segment**
   tier (travel/active%/elevation/SPARC), and the **derived** tier — all from the
   one self-contained page (still no external scripts/CDN). The honesty flags
   carry straight through the UI: a `clinical:false` joint reads **relative** and
   its rows **dim while the view shows Raw** (mirroring the scene's amber "· raw"
   overlay), a blocked joint names its missing node, and each derived metric keeps
   its note. The panel **shares the raw↔calibrated toggle**, and hovering a
   joint/segment row **highlights the bone(s) it measures** in the scene (via the
   baked `joint_segments` adjacency). `analyze_session` now runs metrics *before*
   render (steps 4/5 → 5/5) and passes it in, so one command produces the whole
   review. *(Live per-frame angle read-out — a scrubber-linked value under each
   DOF — is a natural follow-up; it needs the per-frame series added to the baked
   payload, whereas today the panel carries session summaries only.)*
