Jamie215/HULC_motionshirt/(commit log)

2026-07-30 Fix periodic BNO086 idle reset that spikes sleep current
    The BNO086 was rebooting on a fixed ~6.6s cadence in IDLE, and each reboot
    (sensor inrush + full I2C reconfiguration burst) prevented IDLE from settling
    into its low-power floor, defeating the battery-saving intent of sleep.
    Root cause: the BNO INT line is level-meaningful (LOW = data waiting) but the
    host ISR is edge-triggered (FALLING). When a report became ready while INT was
    already asserted, no fresh falling edge was produced, imuDataReady stayed
    false, and __WFE() slept through the pending data. The BNO retried per its
    ~10ms INT timeout and, after being ignored long enough, its internal watchdog
    rebooted the part — the periodi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
    [firmware.ino]
2026-07-30 Add IDLE_WAKE_SOURCE diagnostic to isolate the periodic BNO self-reset
    The ~6.9s BNO086 self-reset in IDLE persists unchanged after the INT
    edge/level fix, so host-side interrupt handling is ruled out. getResetReason()
    only reflects the boot-time cause (the library caches prodIds at begin() and
    never refreshes it on later resets), so it is not a live per-reset probe.
    Add a single compile-time knob, IDLE_WAKE_SOURCE, and a shared
    enableIdleReports() helper to A/B test the two remaining suspects on the bench:
    0 = Stability Detector 0x1C only (normal)
    1 = no reports enabled -> resets persist means hardware/power; resets stop
    means the 0x1C config is the trigger
    2 = continuous low-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
    [firmware.ino]
2026-07-30 Fix BNO086 ~6.9s idle self-reset by using Stability Classifier in IDLE
    Bench A/B testing with the IDLE_WAKE_SOURCE diagnostic isolated the cause:
    enabling the Stability Detector (0x1C) is what makes the BNO086 self-reset on
    a fixed ~6.9s cadence in IDLE. With 0x1C disabled (arm 1) or replaced by a
    rotation vector (arm 2), the periodic resets stopped entirely — only the
    expected one-time boot-softReset event remained. It was never power or host
    INT handling; it was the 0x1C report config.
    Switch IDLE to the Stability Classifier (0x13) — the same report already run
    in STATIC/ACTIVE with no resets. It reports the same STATIONARY/ON_TABLE/
    MOTION classes, so IDLE wakes to ACTIVE_RECORDING o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
    [firmware.ino]
2026-07-30 Change to arduinoIDE configuration
    Fixes the periodic soft-reset wakeup by replacing stability detector with stability classifier, however this now makes the base current consumption 22mA
    [firmware.ino]
2026-07-31 Arm Significant Motion (0x12) as the IDLE wake source
    Replace the IDLE Stability Classifier (0x13) with the Significant Motion
    detector (0x12) — a one-shot, low-power, self-disarming wake sensor. IDLE
    now stays silent (no periodic reports or INT edges) until real motion, at
    which point a single 0x12 event drives the transition to ACTIVE_RECORDING.
    - enableIdleReports() arms 0x12 via the generic enableReport() (no SparkFun
    helper exists); configureBNO_Idle() and the reset-recovery path stay in
    sync through it, and re-arm on every IDLE entry since the detector
    auto-disarms after firing.
    - handleIdle() triggers on the 0x12 event itself (no payload needed) and
    logs the raw report ID s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
    [firmware.ino]
2026-07-31 Add optional BNO hub deep sleep (sh2_devSleep) in IDLE
    Layer an experimental deep-sleep path on top of the Significant Motion
    wake source, gated behind IDLE_USE_DEVSLEEP. When enabled, IDLE both arms
    0x12 and drops the BNO sensor hub into executable-channel sleep
    (sh2_devSleep) for lower idle current.
    To survive hub sleep and still wake the nRF, 0x12 is armed via
    sh2_setSensorConfig() directly with wakeupEnabled=true ("wake host on
    event") and alwaysOnEnabled=true ("sensor remains on in sleep state") —
    SparkFun's enableReport() hardcodes both false, so the wrapper can't be
    used here. Symbols come from sh2.h (included by the library header); the
    config falls back to enableReport() if rejec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
2026-07-31 Slow IDLE SigMotion interval 10ms -> 1s to curb devSleep reset loop
    The IDLE Significant Motion interval was left at 10ms (100Hz) — ~6500x
    faster than the classifier's ~65s ceiling (the classifier is capped at a
    uint16 ms param). Under devSleep, a 100Hz sensor forces the sleeping hub
    to rouse constantly and trips its SHTP watchdog roughly every second,
    matching the observed ~1s reset loop (vs the detector's ~6.6s at a 1s
    interval).
    Raise IDLE_SIGMOTION_INTERVAL_US to 1,000,000us (1s) as a single-variable
    A/B against the known detector baseline. Because 0x12 is armed via
    enableReport()/sh2_setSensorConfig (uint32 microseconds), the interval can
    go up to ~71 min — far more headroom than t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
    [firmware.ino]
2026-07-31 Isolate devSleep reboot cause: tunable wake flags + reboot timing
    The interval sweep ruled out report interval as the reset driver (10ms and
    1000ms both reboot ~1.17s), and the logs show zero reports serviced between
    reboots — so the BNO is self-rebooting on an internal devSleep timeout, not
    missing an INT. The remaining suspects for the 1.17s (SigMotion, both flags
    on) vs 6.6s (detector, likely flags off) timeout are the wake-sensor flags.
    - Make wakeupEnabled / alwaysOnEnabled tunable via IDLE_WAKE_WAKEUP_EN /
    IDLE_WAKE_ALWAYSON_EN; default to the next test (alwaysOn=0, wakeup=1).
    - Stamp lastDevSleepMs after each modeSleep() and log the exact
    sleep-to-reboot duration in the reset h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
    [firmware.ino]
2026-07-31 Revert IDLE wake source to Stability Detector (0x1C) + devSleep
    Bench results settled the design: under devSleep, SigMotion (0x12) self-
    rebooted every ~1.17s regardless of report interval, and dropping alwaysOn
    collapsed the hold to ~2ms with no motion wake at all — so alwaysOn is
    load-bearing (required), not the reboot cause. The Stability Detector holds
    devSleep ~6x longer (~6.6s) and is the proven 7mA / wakes-on-motion config.
    Revert IDLE to the detector while keeping the devSleep machinery:
    - enableIdleReports() arms 0x1C via sh2_setSensorConfig with wakeupEnabled=1
    and alwaysOnEnabled=1 (restored from the failed alwaysOn=0 experiment);
    IDLE_DETECTOR_INTERVAL_US replaces the SigM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
    [firmware.ino]
2026-07-31 Raise IDLE detector interval 1s -> 10s to cut heartbeat wakeups
    Bench showed the Stability Detector streams a heartbeat report every ~1s
    (its interval), and each wakes the nRF — holding IDLE at ~11mA instead of
    the ~7mA target. Unlike the SigMotion reboot cadence (interval-independent),
    the detector's heartbeat rate tracks IDLE_DETECTOR_INTERVAL_US, so lengthen
    it to 10s to reduce nRF wakeups.
    10s sits just above the ~5s devSleep reboot interval, so the reboot (which
    re-arms the detector and resets the heartbeat timer) should pre-empt the
    heartbeat entirely, leaving the reboot as the wakeup floor. Comment
    documents the uint32-us ceiling (~71 min), the practical reboot-preemption
    cap (past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
    [firmware.ino]
2026-08-07 Add state-machine-only test sketch (no BLE, no flash)
    Standalone build derived from firmware.ino for verifying the
    IDLE / STATIC_POSTURE / ACTIVE_RECORDING transition behaviour in
    isolation. All transition logic, timers, and the watchdog are kept
    identical to production; BLE, QSPI flash, time sync, offload, and the
    flash-fill throttle/full handling are removed.
    Two deliberate test-only differences, documented in the header:
    - devSleep disabled so IDLE stays awake and the ~6.6s hub reboot noise
    is gone, making IDLE->motion->ACTIVE deterministic to observe.
    - IDLE detector interval 10s -> 200ms for snappy motion detection.
    Samples are printed and counted instead of written to flash; an LED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
    [state_machine_test.ino]
2026-08-07 Instrument IDLE reset: selectable wake source + held-since-arm timing
    Bench log showed the BNO self-reboots ~every 6.4s in IDLE with the hub
    awake (devSleep off), proving the reboot is not a devSleep artifact.
    Add IDLE_WAKE_SOURCE selector (DETECTOR / NONE / SIGMOTION) and print
    'held Nms since arm' plus reset reason on each IDLE reset, so the
    per-config reboot period can be measured and the cause localized. Also
    log every raw IDLE event id to confirm the wake sensor is silent at rest.
    Claude-Session: https://claude.ai/code/session_01CCdYBz3gP44vprsZXgLHyn
    [state_machine_test.ino]
2026-08-07 Add streaming-accelerometer IDLE wake option (IDLE_WAKE_ACCEL)
    Bench runs showed: NONE and SIGMOTION reset ~0.68s, DETECTOR ~6.4s, all
    reason=2 (Internal System Reset), independent of devSleep and report
    interval. All prior options are gesture/detector-class sensors.
    Add IDLE_WAKE_ACCEL: stream the accelerometer and detect motion host-side
    via |a| deviation from gravity, to test whether a continuously-streaming
    sensor avoids the internal reset entirely (and thus serves as a viable
    reboot-free IDLE wake source). Set as default so the next flash tests it.
    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
    [state_machine_test.ino]
2026-08-07 Add automatic detector interval sweep for reboot-period test
    When IDLE_DETECTOR_SWEEP is on and the wake source is DETECTOR, IDLE
    auto-cycles the report interval through 50ms / 200ms / 1s / 5s, holding
    each for 3 genuine reboots and printing 'SWEEP: interval=Xus held=Yms'
    per reboot. Post-arm settle resets (<300ms) are filtered out. One flash
    now yields a full table showing whether the ~6.5s internal-reset period
    tracks the report interval, replacing the earlier cross-build inference.
    Default wake source set back to DETECTOR so the sweep runs on next flash.
    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
    [state_machine_test.ino]
2026-08-07 Sweep: add reports-since-arm counter and bracket the reboot knee
    The interval sweep revealed a step function, not a flat line: detector
    holds ~6.4s at 50-200ms intervals but collapses to ~930ms (near the
    bare-hub baseline) at 1s and 5s. Working model: a detector report must
    arrive before the ~930ms baseline reboot to enter the long-hold regime;
    at >=1s intervals the first report never beats the baseline.
    Add reportsSinceArm to each reset line to test that model directly
    (reports==0 on a ~930ms reboot confirms it), and add 500ms/800ms sweep
    points to locate the knee between 200ms and 1s.
    Claude-Session: https://claude.ai/code/session_0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
    [state_machine_test.ino]
2026-08-07 Record detector sweep findings; hand off to streaming-accel test
    Sweep confirmed the reboot is a race: bare hub reboots at a ~930ms
    baseline, but a detector report serviced before then extends the hold to
    a hard ~6.5s ceiling. First report lands ~one interval after arming, so
    <=500ms intervals beat the baseline (long hold) and >=800ms miss it
    (0 reports, ~930ms reboot). ~6.5s is the best the detector allows; no
    interval tuning eliminates the reboot.
    Document the full table/conclusion in-file, disable the now-complete
    sweep, and set IDLE_WAKE_ACCEL as default to test whether a streaming
    sensor avoids the internal reset entirely.
    Claude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
    [state_machine_test.ino]
2026-08-07 Add poll-vs-WFE IDLE servicing mode to test missed-read hypothesis
    The ~6.5s detector reboot fires while reports are actively flowing, which
    a pure 'reset if unserviced' model can't explain. Two hypotheses remain:
    (a) a real independent hub reset, or (b) an occasional missed read (the
    edge-triggered ISR sleeping through a level-asserted INT) that goes
    unserviced ~6.5s -> reset.
    Add IDLE_SERVICE_MODE (WFE vs POLL). POLL never sleeps, so getSensorEvent()
    is called continuously and no report can be slept through. If ~6.5s
    persists under POLL it's (a) intrinsic; if it vanishes it's (b), fixable.
    Default set to POLL + DETECTOR regime so the next flash runs the test;
    reports-since-arm now printed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
    [state_machine_test.ino]
2026-08-07 Record POLL result: detector reboot is intrinsic; hand off to accel
    POLL run: held 6433ms, reports=30 — identical to WFE. Relentless polling
    changed nothing, so the ~6.5s detector reboot is a genuine independent
    hub reset, not a missed-read artifact. It persisted under continuous
    polling, so the bus-traffic confound is moot. Detector reboot is now
    proven independent of devSleep, report interval, AND servicing — firmware
    cannot remove it while the detector is the wake source.
    Restore IDLE_SERVICE_MODE=WFE (poll was a diagnostic) and set default
    wake source to IDLE_WAKE_ACCEL for the streaming-sensor test.
    Claude-Session: https://cl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
    [state_machine_test.ino]
2026-08-07 Harden accel motion detection: debounce + noise-floor readout
    Address the concern that raw-accel motion detection is noisier than the
    on-chip detector. Require IDLE_ACCEL_MOTION_SAMPLES (3) consecutive
    above-threshold samples before transitioning so a single spike can't flip
    the state, and print the peak |a|-1g deviation per 3s IDLE heartbeat so
    the threshold can be calibrated just above the actual noise floor.
    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
    [state_machine_test.ino]
2026-08-07 Record accel result: streaming also resets ~6.5s — reboot is systemic
    The streaming accelerometer resets at ~6.5s (reason=2) just like the
    detector, so the internal reset is not specific to detector-class
    features. Final conclusion: no firmware wake configuration avoids the
    ~6.5s reset — it is independent of devSleep, report interval, servicing,
    and sensor type. Eliminating it requires a hardware wake path.
    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
    [state_machine_test.ino]
2026-08-07 Test the servicing-starvation reset theory: 400kHz I2C + INT-stuck probe
    A proposed explanation attributes the ~6.5s reset to a watchdog fired by
    the host failing to service H_INTN (communication starvation). Our POLL
    experiment already refutes the 'host too slow' form (perfect servicing,
    still 6.5s), but two variants remain untested: a library that fails to
    consume a packet (so INT never clears despite polling), and slow I2C.
    Add a diagnostic: after draining all events, if INT is still LOW but
    getSensorEvent() yields nothing (rechecked 200us later), log
    'UNHANDLED PACKET suspected' — the direct signature of that theory. Also
    set I2C to 400kHz (was core-default 100kHz) to test the bus-spe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
    [state_machine_test.ino]
2026-08-07 Retest detector across I2C bus speeds
    Point wake source back at the detector and run it at 400kHz (all prior
    data was at the 100kHz core default — bus speed was never varied before).
    Reflash with I2C_CLOCK_HZ = 100000 / 250000 / 400000 to see if the ~6.5s
    reset period tracks bus speed. The INT-stuck probe also runs in detector
    mode, so this run doubles as a starvation check for the detector path.
    Note: referenced SparkFun issue #2 is about SPI + a resetCheck() inside
    enableReport(), not I2C speed — a separate host-side lead, not this test.
    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
    [state_machine_test.ino]
2026-08-07 Dig #1: fresh Product-ID reset-cause probe on each IDLE reset
    getResetReason() may be boot-cached, so 'reason=2' on every periodic reset
    could be a stale echo of the initial softReset. On each reset, call the
    sh2 layer directly (sh2_getProdIds) to force a fresh Product-ID read and
    print the reset cause it reports right now, alongside the cached value.
    If fresh==cached==2 every cycle, each periodic reset is genuinely an
    Internal System Reset; a divergence would reveal the cache is misleading.
    Uses the same direct-sh2 pattern the production firmware uses for
    sh2_setSensorConfig(). Gated by IDLE_PRODID_PROBE.
    Claude-Session: https://clau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
    [state_machine_test.ino]
2026-08-07 Revert I2C to 100kHz to isolate fresh reset-cause probe
    Big finding: the fresh Product-ID probe reported resetCause=4 (External
    Reset), NOT the cached 2 (Internal System Reset) we'd been trusting for
    many iterations — the cached value was the boot softReset echoed. So the
    reset is a hardware/pin reset, likely triggered host-side, not a CEVA
    firmware self-reset.
    But that run changed two variables at once (400kHz + probe) and went
    pathological: ~130ms reset loop, reports=0, constant INT-stuck/unhandled-
    packet corruption — 400kHz destabilized this board's I2C bus. Revert to
    100kHz, keep the probe, to read the true fresh cause at the original
    steady ~6.5s condition and cleanly attribute it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
    [state_machine_test.ino]
2026-08-07 Disable Product-ID probe: it was causing the resets (observer effect)
    At 100kHz the probe build STILL shows ~146ms resets / resetCause=4 /
    reports=0 — identical to the 400kHz build. Reverting bus speed changed
    nothing, so 400kHz was never the cause: the common factor is the probe.
    The direct sh2_getProdIds() call corrupts the SparkFun library's sh2
    state, and the library recovers via a hardware (pin) reset — that is the
    External Reset (cause 4) we saw.
    So last commit's 'reset is External, likely fixable' conclusion is
    retracted: resetCause=4 is a probe-induced artifact, not the cause of the
    original ~6.5s reboot, which remains unknown. Disable the probe to confirm
    it was the disruptor a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
    [state_machine_test.ino]
2026-08-11 Add plain-language findings doc for the IDLE reset investigation
    Captures the whole investigation: the question, the experiments (devSleep,
    interval sweep, poll-vs-WFE, accel, I2C speed) and what each ruled out, the
    race/ceiling model, the datasheet analysis, the probe observer-effect
    mistake and its lesson, the I2C-transport conclusion (strongly suspected
    but unconfirmed without SPI), and the recommendation to accept it as benign
    and add I2C deadlock recovery.
    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
2026-08-11 Set build back to POLL mode to re-observe the polling behaviour
    Detector wake source, 100kHz, probe off (the clean POLL config that gave
    ~6.4s resets). Lets the behaviour be re-observed on the bench.
    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
    [state_machine_test.ino]
2026-08-11 Instrument clean same-build POLL vs WFE A/B
    Add a self-labeling startup banner (SERVICE MODE: POLL/WFE) and a running
    reset-stat line (n / mean / min / max of held-before-reset, sub-1s
    excluded) so each mode yields one comparable number from the SAME binary.
    Flip IDLE_SERVICE_MODE and reflash to get the matching pair — replacing
    the earlier cross-build comparison.
    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
    [state_machine_test.ino]
2026-08-11 Harden firmware.ino against I2C/BNO086 failure modes
    Three defensive measures from the idle-reset investigation (none 'fix' the
    ~6.5s reset, whose cause stays I2C-transport-suspected/unconfirmed, but each
    guards a real failure mode we surfaced):
    1. I2C bus recovery (i2cBusRecover): if a mid-transaction BNO reset leaves a
    slave holding SDA low, the nRF52840 can't issue a START and hangs until
    power-cycle. Bit-bang up to 9 SCL pulses + a STOP to free the bus; called
    before Wire.begin(). No-op when the bus is free.
    2. enableReport pacing: 50ms after each report enable in configureBNO_Running,
    so rapid back-to-back Set-Feature frames don't overload the SH-2 command
    buffer and tr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
    [firmware.ino]
2026-08-11 Add IDLE_WAKE_RV: test whether streaming quaternions also reset
    Arms the Rotation Vector as the IDLE report (15Hz, like ACTIVE recording)
    with the same reset logging, to answer whether continuously reading
    quaternions resets ~6.5s like the detector and accelerometer did, or is
    genuinely exempt. Motion is detected via per-sample quaternion change so it
    stays a live wake source. Only the wake source changed from the A/B build
    (servicing stays POLL, already proven irrelevant) — single variable.
    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
    [state_machine_test.ino]
2026-08-11 RV result overturns the conclusion: reset is fusion-engine-gated, not I2C
    The Rotation Vector streamed 300+ reports with ZERO resets, while the
    detector and accelerometer reset every ~6.5s. This disproves the earlier
    I2C-transport theory (transport-level would hit RV too) and pins the cause:
    the BNO086 self-resets when idling in a lightweight, non-fusion sensor mode;
    running the fusion engine (Rotation Vector) keeps the hub active and it never
    resets. Explains why it's not seen elsewhere (everyone streams fused output)
    and why ACTIVE recording (RV) is unaffected.
    - Rewrite FINDINGS.md conclusion from I2C-transport to fusion-engine-gated;
    reframe recommendation as a power-vs-reset tradeoff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
    [state_machine_test.ino]
2026-08-11 Add IDLE_WAKE_CLASSIFIER: test whether the accel+gyro classifier resets
    Datasheet 2.4.1 says the Stability Classifier uses accel+gyro via the
    MotionEngine (higher power), while the Detector is accelerometer-only
    (lower power). Prediction from the RV result: sensors that run the
    MotionEngine don't reset. Arm the Stability Classifier (0x13) alone in
    IDLE and watch for resets — if reset-free, it confirms the mechanism and
    offers a middle-ground reset-free IDLE wake between the detector and RV.
    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
    [state_machine_test.ino]
2026-08-12 Confirm classifier is reset-free: mechanism fully pinned
    Stability Classifier (accel+gyro/MotionEngine) armed in IDLE ran with zero
    resets over 2+ minutes — confirming the prediction and completing the sensor
    table: accelerometer-only sensors restart, MotionEngine sensors don't.
    Update FINDINGS: mark the classifier row confirmed, add the full four-sensor
    table, and document the IDLE wake options as a power-vs-restart menu (detector
    = lowest power + restart; classifier = reset-free middle ground at higher
    power; RV = highest power).
    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
2026-08-12 Add Stability Classifier as selectable IDLE wake source
    The reset investigation (state_machine_test/FINDINGS.md) established that the
    periodic ~6.6s IDLE reboot is gated by the BNO086 fusion engine: accel-only
    sensors (the Stability Detector) self-reset in idle, while sensors that run the
    MotionEngine do not. Carry that finding into the production firmware.
    - Add IDLE_WAKE_SOURCE compile-time selector (DETECTOR vs CLASSIFIER),
    defaulting to CLASSIFIER. The Stability Classifier (0x13, accel+gyro) becomes
    the IDLE state-changing flag, waking IDLE->ACTIVE on the same MOTION value
    STATIC_POSTURE and ACTIVE_RECORDING already use.
    - Derive IDLE_USE_DEVSLEEP from the wake source: the classif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
    [firmware.ino]
2026-08-12 Fix build: alias SDA/SCL to Wire pin defines for XIAO nRF52840 mbed core
    i2cBusRecover() references the SDA/SCL convenience macros, which the Seeed XIAO
    nRF52840 mbed core does not define (AVR/ESP cores do), causing a compile error:
    'SDA' was not declared in this scope. Alias SDA/SCL to PIN_WIRE_SDA/PIN_WIRE_SCL
    — the canonical Wire pin defines this core provides — guarded with #ifndef so
    cores that already define them are unaffected.
    Claude-Session: https://claude.ai/code/session_01Fp2NxNH7X4YHHFpunVaiUg
    [firmware.ino]
2026-08-12 Realign STABILITY_* constants to sh2 library values (fix off-by-one)
    getStabilityClassifier() returns the raw sh2 classification: 0=Unknown,
    1=OnTable, 2=Stationary, 3=Stable, 4=Motion. The STABILITY_* defines were
    shifted down by one (ON_TABLE=0 .. MOTION=3), bench-confirmed by real Motion
    printing as "UNKNOWN(motion assumed) (4)". Consequences in STATIC_POSTURE /
    ACTIVE_RECORDING: real Stable(3) was wrongly counted as motion, and the
    ON_TABLE checks matched Unknown(0) instead of a real on-table.
    - Add STABILITY_UNKNOWN=0 and shift ON_TABLE/STATIONARY/STABLE/MOTION to 1..4.
    - Add the UNKNOWN case to stabilityName().
    - isMotion() body unchanged (s >= STABILITY_MOTION), now correctly meaning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
    [firmware.ino]
2026-08-12 Add detector devSleep-vs-wake diagnostic
    Investigate why the Stability Detector build does not transition IDLE->ACTIVE on
    motion, isolating devSleep as a possible cause.
    - DETECTOR_DIAG_NO_DEVSLEEP flag: when 1, the DETECTOR build runs with the hub
    awake (IDLE_USE_DEVSLEEP forced 0), so the detector emits change-events
    continuously instead of possibly being coalesced to heartbeats under devSleep.
    No effect on the classifier build.
    - Log the raw getStabilityClassifier() value on every 0x1C event (not just when
    it equals EXITED), so a bench shake shows whether the value ever reaches
    EXITED(2). Line also prints the active devSleep state for the A/B.
    Run: flash detector build, shake,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
    [firmware.ino]
2026-08-12 Set IDLE_DETECTOR_INTERVAL_US to 500ms (was 10s)
    The 10s interval kept the detector build in the ~840ms baseline-reboot floor: at
    10s the first heartbeat never lands before the hub's ~840ms devSleep reboot, so
    the detector rarely reports (only occasionally surviving to ~10s for a single
    report) and idle sits at ~12mA. A report must arrive within ~800ms of an arm to
    stretch the hold to the ~6.5s ceiling, so the interval must be shorter than the
    baseline reboot. 500ms achieves the ceiling and streams reports every ~430ms,
    which the detector motion-wake diagnostic needs (frequent reports so a shake can
    surface a readable EXITED). Detector build only; the classifier path ignores it.
    This value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
    [firmware.ino]
2026-08-12 Remove outdated code and bench instrumentation from firmware.ino
    Clean up dead defines, stale comments, and investigation-era diagnostic
    logging left over from the concluded IDLE-reset investigation:
    - Drop SH2_SIGNIFICANT_MOTION (0x12) define and its comment — no longer
    the IDLE wake source and unreferenced in this file
    - Drop IDLE_STABILITY_MS — explicitly retained-but-unused
    - Fix eraseLog() comment: it is now wired to control command 0x03
    - Remove lastDevSleepMs devSleep hold-time instrumentation and the
    verbose per-reset / per-event bench logging in handleIdle()
    Functional behavior is unchanged: detector re-arm, post-reset drain,
    devSleep re-entry, and the EXITED -> ACTIVE_REC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
    [firmware.ino]
2026-08-19 Fix build: restore IDLE_WAKE_* defines dropped by the PR #6 merge
    The PR #6 cleanup branch was cut before the Stability Classifier wake
    source existed, so merging it deleted the IDLE_WAKE_SOURCE switch and
    IDLE_STABILITY_MS while the classifier body code survived. That left
    firmware.ino referencing IDLE_WAKE_NAME (lines 853/874, outside any #if)
    with no definition — a hard compile error — and the IDLE_WAKE_SOURCE
    #if guards silently falling through to 0.
    Restore the compile-time A/B switch:
    - IDLE_WAKE_DETECTOR / IDLE_WAKE_CLASSIFIER / IDLE_WAKE_SOURCE and the
    IDLE_WAKE_NAME ladder (with an #error guard on misconfiguration)
    - IDLE_STABILITY_MS (1000), referenced by the classifier armi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
    [firmware.ino]
2026-08-25 Add multi-node BLE sync: per-node identity, ms time sync, test harness
    Foundation for testing a synced BLE connection across multiple IMU nodes
    (motion shirt uses one IMU per body segment; their streams are only fusable
    if the nodes share a common time base to within a few ms).
    Firmware (firmware.ino):
    - Unique per-board advertised name HULC-IMU-XXXX derived from the read-only
    FICR DEVICEID (previously all boards advertised HULC-IMU-01 and collided;
    suffix is stable per board with no per-board reflash).
    - Millisecond-resolution time sync via new control command 0x05 (uint64
    epoch ms). Legacy 0x02 (seconds) still works and now also populates the
    ms mapping. Control characteristic wid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
    [firmware.ino]
2026-08-26 Fix build: derive node suffix from BLE MAC, not NRF_FICR
    The multi-node commit referenced NRF_FICR->DEVICEID for the per-board name
    suffix. That MDK symbol is not available in this build (Seeed XIAO nRF52840
    mbed core), breaking compilation — the previous firmware never used it.
    Derive the unique suffix from the last 4 hex chars of BLE.address() instead.
    This uses only ArduinoBLE (already compiled and working in this project) and
    needs no nRF MDK headers. makeDeviceName() now runs just after BLE.begin(),
    where BLE.address() is valid. Behavior is unchanged: each board still gets a
    stable, unique HULC-IMU-XXXX name with no per-board reflash.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
    [firmware.ino]
2026-08-26 Fix build: restore dropped IDLE classifier #if/#else in handleIdle()
    The mainline merge that produced e34832a (this branch's base) mangled the
    IDLE wake-source preprocessor block in handleIdle(): the opening
    '#if IDLE_WAKE_SOURCE == IDLE_WAKE_CLASSIFIER ... #else' was dropped but the
    closing '#endif' was left behind, giving "error: #endif without #if". This
    is a pre-existing bug on mainline (e34832a), independent of the multi-node
    work — origin/main itself is balanced; a later merge broke it.
    Restore the classifier branch and the '#else' so the trailing '#endif' has
    its opener again, matching origin/main's logic in the current (simpler)
    function style. All referenced symbols already exist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
    [firmware.ino]
2026-08-26 Fix build: remove orphaned idleArmedMs assignment in enableIdleReports()
    Second fallout from the same botched mainline merge: commit 581ab0d removed
    the idle reset-hold stats instrumentation (idleArmedMs / idleResetCount /
    idleHeldSum / ... and their globals), but left one dangling write
    `idleArmedMs = millis();` at the end of enableIdleReports(), giving
    "'idleArmedMs' was not declared in this scope".
    idleArmedMs has no declaration and no other reference anywhere in the file,
    so the marker is dead — remove the line. Verified none of the sibling stats
    symbols remain referenced; preprocessor and brace balance both check out.
    Claude-Se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
    [firmware.ino]
2026-08-26 Make multinode harness report honest uncertainty, not false precision
    First 2-node bench run showed A005 read windows of 300-800ms — the reads,
    not the clocks, dominate the measurement. The old report presented offset
    mean/stdev and a drift figure as if calibrated; a -188 ms/min "drift"
    (~3000 ppm, physically impossible for a crystal) was really the read-latency
    transient.
    Rework report_offsets to:
    - weight the offset estimate to the lowest-uncertainty (tightest read window)
    subset and print it as value +/- the read-window bound (an upper bound, not
    a calibrated value);
    - compute drift as a least-squares slope and print NOT RESOLVABLE whenever it
    falls below the read-latency noise f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
2026-08-26 Request fast BLE connection interval (7.5-15ms) for low-latency GATT
    Path A of the multi-node sync work. The first 2-node run measured A005 read
    windows of 300-800ms, which floored cross-node offset measurement — the reads,
    not the clocks, dominated. The central had negotiated a slow connection
    interval because the firmware never expressed a preference.
    Call BLE.setConnectionInterval(6, 12) (units of 1.25ms -> 7.5-15ms) before
    advertise() so it becomes the advertised preferred connection parameters. The
    central may clamp to its own limits, but this pushes read/notify latency down
    by roughly an order of magnitude, making the live offset method usable — and
    it is also needed for real-time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
2026-08-26 Harness: re-read status after sync to confirm every node synced
    The pre-sync STATUS line reports each node's leftover timeSynced RAM flag
    (not persisted; resets every boot), which caused confusion when two nodes
    with different power/reflash histories showed synced=False vs True BEFORE the
    run's sync ran. Both were in fact synced by the run (both [SYNC] lines fire).
    Label the pre-sync status as stale, and add an authoritative post-sync status
    re-read that asserts every connected node reports synced=True, with a WARNING
    if any did not. read_status() now returns the synced flag.
    Claude-Session: https://claude.ai/code/session_0149LiHFxDQ6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
2026-08-26 Harness: richer read-window stats + single-node diagnostic guidance
    Add min/median/p90/max to the per-node read-window report so one board on
    its own gives a clean latency profile. When run with a single node, print
    how to read it against a 2-node run: similar latency implicates the
    firmware/host link (fast interval not honored); much lower single-node
    latency implicates the host's 2-connection scheduling.
    Claude-Session: https://claude.ai/code/session_0149LiHFxDQ6ZdtS8iB1mTgv
2026-08-26 Multi-node sync: iOS-compliant interval, offload throughput mode, design doc
    Design clarified: nodes stay wireless (no shared line) and analysis is
    post-collection, so there is no real-time requirement — alignment is done
    offline by reconciling each node's clock. The connection interval is the one
    thing both requirements hinge on (offload throughput + offset-measurement
    accuracy), and the ~850ms latency is host-side (Windows), not the firmware.
    Changes:
    - firmware: request 15-30ms connection interval (setConnectionInterval(12,24))
    instead of 7.5-15ms. 15ms is the floor because Apple's BLE guidelines reject
    a requested Interval Min < 15ms, so the old value would fail on iPhone. New
    v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
    [firmware.ino]
2026-08-27 Measure real offload throughput on-device (fix bogus timing estimate)
    The old "[OFFLOAD] Done ... sent in Ns" line computed chunk_count * 3ms pacing
    — the theoretical minimum, ignoring the BLE connection interval that actually
    gates the transfer. It always reported an unrealistically fast time.
    Time the offload loop with millis() instead. offloadChar.writeValue() applies
    backpressure when the TX buffer is full, so the loop runs at the real
    connection pace and elapsed wall-clock is the true transfer time. Report:
    bytes, chunk count, elapsed ms, throughput KB/s, and ms/chunk. Because one
    notification is delivered per connection event, ms/chunk ~= the effective
    connection interval the centra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
    [firmware.ino]
2026-08-27 Add offline node reconciliation tool (BLE-latency-independent sync)
    reconcile_nodes.py aligns offloaded per-node quaternion logs onto one common
    timeline by cross-correlating the motion itself — angular speed (magnitude of
    the rotation rate between consecutive quaternions), which is mounting-invariant,
    so two sensors on the same moving body are comparable regardless of orientation.
    Because alignment comes from the shared motion, it does NOT depend on BLE read
    latency; a slow link only slows offload, not alignment accuracy. This is the
    production sync path for the wireless, post-collection design.
    - Decodes the firmware's 20-byte records; emits an aligned CSV with a unified
    t_common colu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
2026-08-27 reconcile: add confidence gate for the independent-motion case
    Cross-correlation only works when nodes share motion. Two nodes on
    independently moving limbs (one arm swinging, the other still) share nothing to
    correlate, so a naive offset would be noise. Add a confidence score (Pearson
    correlation of the two angular-speed signals at the best lag) and flag results
    below CONFIDENCE_MIN as unreliable, telling the caller to fall back to the BLE
    clock-offset read and/or a start-of-session sync gesture.
    Self-test now covers both cases: shared motion -> confidence 0.93 (reliable),
    independent motion -> 0.07 (correctly flagged). Design doc updated: BLE offset
    read + sync gesture is the PRIMARY alig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
2026-08-28 Fix no-recording: default IDLE wake to CLASSIFIER (accel+gyro)
    Rotating a rigid body produced no log: the Stability Detector wake source is
    accelerometer-ONLY, and pure rotation makes little linear acceleration, so it
    never tripped — the node stayed in IDLE and logged nothing. Switch the default
    IDLE_WAKE_SOURCE to the Classifier (accel+gyro via the MotionEngine), which
    detects rotation. Trade-off: higher idle current (no devSleep) — documented
    inline; flip back to DETECTOR for the low-power path once capture is validated.
    Also stop the offload from hanging on an empty log: measure_offload now bails
    after 8s with no data and tells the user the flash is empty, instead of waiting
    out the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
    [firmware.ino]
2026-08-28 Add Significant Motion (0x12) as a third selectable IDLE wake source
    The Stability Detector didn't wake on a bench shake (node stayed in IDLE,
    nothing logged); the Classifier did. Add IDLE_WAKE_SIGMOTION to A/B a
    purpose-built low-power wake-on-motion primitive against the detector.
    Significant Motion (0x12) is a one-shot wake event — its arrival alone signals
    motion (no value to decode), and it auto-disables after firing, so
    enableIdleReports() re-arms it each IDLE entry/reset. It's accel-based like the
    detector, so it reuses the devSleep path (IDLE_USE_DEVSLEEP now covers both
    accel-only sources; DETECTOR_DIAG_NO_DEVSLEEP still forces hub-awake for either).
    enableIdleReports() and handl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
    [firmware.ino]
2026-08-28 Restore working detector wake: devSleep off, 1s ms interval
    Comparing against the original working firmware pinpointed why the Stability
    Detector stopped waking on motion. Three regressions, all added when chasing
    lower idle current:
    1. devSleep (imu.modeSleep + sh2 wake/always-on) — with the hub asleep the
    detector's EXITED wake event is coalesced/rarely delivered (shaking only
    occasionally logged a 0x1C val line; state never changed).
    2. Report interval stretched 1s -> 10s.
    3. Unit bug: the _US (microsecond) interval was passed to imu.enableReport(),
    which takes MILLISECONDS -> a report every ~2.8 hours on the non-devSleep
    path.
    Fixes: DETECTOR_DIAG_NO_DEVSLEEP defaults 1 (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
    [firmware.ino]
2026-08-28 Harness: add --name to target a specific node for offload
    Running --offload with two nodes connected silently offloaded connected[0]
    (the alphabetically-first name), so `--offload --save nodeA.bin` could write
    the wrong node's log into a mislabeled file. Add --name SUFFIX to filter the
    scan to one node (e.g. --name D067), making offload deterministic:
    `--offload --name D067 --save nodeD067.bin`.
    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
2026-08-28 Harness: --offload now saves every node to its own node-id-named .bin
    Instead of offloading just connected[0] to one --save path, --offload loops
    over every connected node and writes each to <node-id>.bin (e.g.
    HULC-IMU-D067.bin), so a single command captures all nodes with correct,
    unambiguous filenames. --out-dir picks the directory (default cwd); --save
    still overrides the filename when exactly one node is offloaded; --name still
    targets a single node. Node names are sanitized for the filesystem.
    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
2026-08-28 reconcile: fix hang on junk records; FFT xcorr; add --inspect
    Real .bin captures include junk: erased flash decodes to timestamp 0xFFFFFFFF
    and NaN quaternions. One such record made resample_uniform build a grid
    spanning ~4.29e9 ms (hundreds of millions of samples) and np.correlate (O(N*M))
    never returned — the reported hang, plus the "invalid value in divide" warning.
    Fixes:
    - load_log sanitizes: vectorized decode, drop erased-timestamp / NaN /
    zero-norm / non-monotonic records, warn how many dropped, error clearly if
    <2 valid remain.
    - resample_uniform guards against an absurd grid size (corrupt timestamps).
    - swap np.correlate -> FFT-based _xcorr_full (O(N log N); verified identica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
2026-08-28 reconcile: auto-detect record byte offset (framing-shift recovery)
    Real captures came back with every record shifted one byte (a stray 0x02 every
    20 bytes from an offload framing bug), so the naive offset-0 decode produced
    garbage (inf/huge quats, 30s "timestamps") and reconciliation was meaningless.
    The actual data at offset 1 is clean: 100% unit quats, ~8Hz, real motion.
    Add _best_offset(): scan start offsets 0..19 and pick the one whose quaternions
    are most unit-norm, then decode from there (warns when offset != 0). Verified on
    the real B059/D067 captures: both now decode to ~70s of 8Hz motion (up to
    ~3.5 rad/s) and reconcile with confidence 0.63.
    (The framing bug itself still needs fix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
2026-08-28 debug: dump first 60 flash bytes at boot to localize offload framing bug
    Uploaded captures show every 20-byte record in the offloaded .bin carries a
    stray 0x02 prefix with the z high byte truncated. The record WRITE is clean
    (pktBuf = [ts][w][x][y][z], 20 bytes), so the corruption is introduced in the
    BLE transfer/save. Add a one-shot startup hex dump of the flash DATA region:
    if the on-flash bytes are clean 20-byte records, the bug is in offload/notify,
    not the write. Temporary diagnostic; remove once fixed.
    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
    [firmware.ino]
2026-08-29 docs: add MULTINODE_SYNC_MATH.md — full sync/reconciliation derivation
    Record the logic and math behind multi-node time alignment for documentation:
    the two-parameter clock model (offset + drift), the mounting-invariant
    angular-speed feature, cross-correlation time-delay estimation with the
    relative->absolute offset derivation, parabolic sub-sample refinement, the
    Pearson confidence gate, windowed drift estimation, nlerp resampling, the
    synthetic-selftest validation, known limitations, the academic basis
    (GCC/Knapp-Carter, standard clock-sync model), and the upgrades needed for a
    ground-truthed/publishable result. Cross-linked from MULTINODE_SYNC_DESIGN.md;
    equations reference the tools/re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
2026-08-31 docs: LaTeX math in MULTINODE_SYNC_MATH.md; make flash-dump unconditional
    - Rewrite the reconciliation equations as LaTeX (inline $...$ and ```math
    display blocks) so they render on GitHub / Markdown viewers for readability.
    - firmware: the [DBG] flash@DATA_START dump is now unconditional (was gated on
    writeCount>0, so it printed nothing on an empty/erased flash) and reports
    writeCount. All 0xFF = empty flash — capture a session then reboot without
    erasing to see real record bytes.
    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
    [firmware.ino]
2026-08-31 Fix flash record corruption: 4-byte-align QSPI EasyDMA buffers
    Root cause of the offloaded .bin framing bug (every record shifted one byte: a
    stray leading 0x02 + z's high byte truncated). The [DBG] flash dump proved the
    0x02 is on FLASH, not added in BLE transfer — so the record WRITE was wrong,
    even though the packing/writeLogRecord code is clean.
    nRF52 QSPI uses EasyDMA, which requires 4-byte-aligned RAM buffers. pktBuf was a
    bare uint8_t[20] the compiler could place unaligned; EasyDMA then read 20 bytes
    from the word-aligned address below it, prepending the preceding memory byte
    (consistently 0x02 = STATE_ACTIVE) and dropping the last byte. The write
    returned success, so nothing flagg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
    [firmware.ino]
2026-08-31 Add newest-record flash diagnostic to verify alignment fix without erasing
    The existing [DBG] dumps LOG_DATA_START (the OLDEST records), which may have
    been written by pre-fix firmware and survive reflashing (external QSPI is not
    erased on upload). Add a second dump at writeAddr-60 (the newest 3 records the
    current firmware just wrote) so the 4-byte-alignment fix can be verified from a
    power-cycle without erasing the flash.
    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
    [firmware.ino]
2026-08-31 Fix eraseLog(): check erase results, verify blank, don't falsely reset pointer
    The old eraseLog() ignored every nrfx_qspi_erase/qspiWait return value and
    unconditionally reset writeAddr, so a silently-failed erase (a 64KB block
    issued while the chip was still busy, or a driver error) left stale records
    on flash while the status characteristic reported log=0KB. In practice the
    node kept reporting its pre-erase log size and old 0x02-framed records
    survived across --erase runs.
    - Add qspiEraseBlock64k(): checked 64KB block erase with an erase-sized
    busy-wait (~2s bound) instead of the ~100ms write-sized qspiWait(), so a
    slow block erase completes before the next block is issued.
    - eraseLog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
    [firmware.ino]
2026-08-31 multinode_test: verify erase actually wiped instead of always printing done
    erase_node() printed '[ERASE] done' unconditionally, so a failed firmware
    erase looked identical to a successful one. Read the status log size back
    after the wait and report OK (log=0KB) vs FAILED (log still non-zero), and
    point at the node's USB serial + a possible stale firmware image when the
    wipe did not take. The erase itself is entirely firmware-side; this only
    makes the tool report the outcome honestly.
    Claude-Session: https://claude.ai/code/session_01EUzf8GEMBuBQbyKSYPJ5Pr
2026-08-31 Remove boot-time flash-dump diagnostic now that the fix is confirmed
    The [DBG] flash@DATA_START / flash@writeAddr-60 dumps were added to localize
    the 0x02-per-record framing bug. The alignment fix and a verified flash wipe
    are both confirmed, so the scaffolding (marked 'Remove once resolved') is no
    longer needed and boot output is back to clean.
    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
    [firmware.ino]
2026-08-31 multinode_test: retry flaky connects and skip failed nodes instead of crashing
    The connect loop had no per-node error handling, so a single transient WinRT
    failure (service-discovery CancelledError -> TimeoutError, common when a second
    peripheral connects right after the first) raised out of the loop, ran the
    finally block that disconnected the already-connected nodes, and crashed the
    whole run.
    Add connect_with_retry(): up to 3 attempts with a fresh client and short
    backoff, returning None on persistent failure. The loop now prints
    'FAILED — skipping this node' and continues, so one bad connect no longer
    takes down the others; the existing 'no nodes connected' guard still catches
    the all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
2026-08-31 Add temporary RV-vs-classifier stream heartbeat for ACTIVE_RECORDING
    Instruments handleActiveRecording() to report, once per second, how many
    rotation-vector events vs stability-classifier events arrived. This isolates
    the cause of the multi-second gaps seen in offloaded logs: a gap that shows
    rv=0 while stab>0 proves the rotation-vector report stream stalled while the
    sensor and its classifier stayed alive (which also explains why no BNO reset
    or host-watchdog line appears — the classifier keeps lastStabilityEvent fresh).
    Compile-guarded by DEBUG_STREAM_HEARTBEAT; counts and prints only, no
    functional change. To be removed once the gap cause is confirmed.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
    [firmware.ino]
2026-08-31 Make flash offload loss-detecting and self-healing; drop debug heartbeat
    Root cause of the multi-second "gaps" in offloaded logs: A004 notifications
    are unacknowledged, so any notification the central drops silently removes a
    run of records from the middle of the reconstructed file. The recording and
    flash were never at fault — the gap durations are exact multiples of one
    200-byte (10-record) chunk, the fingerprint of dropped notifications.
    Firmware (offloadLog):
    - Frame every notification as [4-byte LE offset][payload] and send a header
    notification first with a sentinel offset carrying the exact total length.
    Framing stays within the existing 200-byte notification, so no MTU change.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
2026-08-31 Document framed, loss-detecting flash offload in MULTINODE_TESTING
    Explains why the multi-second "gaps" in offloaded logs were dropped, unacked
    A004 notifications (gap = exact chunk multiples, clean records either side,
    nothing in serial), the [offset][payload] framing + header total, and how to
    read the host's COMPLETE / INCOMPLETE / re-offload output.
    Claude-Session: https://claude.ai/code/session_01PM7Mgud9dchNvJTPoEeDXq
2026-08-31 Fix offload backpressure — stop dropping ~half the notifications at the sender
    Field test showed attempt 1 delivering only ~55% of bytes (e.g. 3528/6400),
    with each pass finishing in 0.2-0.7s: the firmware was firing a notification
    every 3ms and ALWAYS advancing, even when offloadChar.writeValue() failed
    because the BLE TX buffer was full (no ACL credits for the negotiated
    connection interval). Those notifications were silently dropped at the source,
    which is why re-offload/merge converged slowly and sometimes added 0 bytes.
    Add offloadSend(): retry the same notification, pumping BLE.poll() so a
    connection event can drain the queue, until the stack accepts it (or the link
    drops / a per-pa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
    [firmware.ino]
2026-08-31 Offload: recover dropped chunks by re-requesting only the missing ranges
    Backpressure cut first-pass loss from ~45% to ~30%, but whole-log re-offloads
    still stalled short: both nodes repeatedly ended missing the SAME offset (1568),
    and several passes added 0 new bytes. That is deterministic central-side loss —
    re-blasting the full log recreates the same fast burst, so WinRT drops a
    notification at the same point every pass, and merging (which only helps random
    loss) can never fill it.
    Fix: re-request only the missing byte ranges instead of the whole log.
    - Firmware: new control command 0x06 [offset u32, length u32] -> offloadRange(),
    which re-sends just that range with the same [offset]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
    [firmware.ino]
2026-08-31 Add --erase-after-offload (wipe only after verified-complete) + docs
    Flash hygiene: the write pointer persists across reboots, so power-cycling a
    node without erasing appends the next recording to the old one, and millis()
    resetting on boot creates a backward-timestamp seam that reconcile drops as
    non-monotonic (the "37 dropped records" observed in testing). Give the offload
    workflow a safe way to keep each node's flash to one session.
    - Host: measure_offload now returns whether the transfer verified COMPLETE.
    New --erase-after-offload erases each node's flash (0x03) ONLY after its
    offload is complete, so data that wasn't fully received is never wiped; an
    incomplete offload is left on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
2026-09-01 Document long-session drift tracking: offset(t) as a fitted curve
    Add MULTINODE_SYNC_MATH.md §11 covering the full-day / long-session case
    that §5's single global offset+drift line does not: model offset(t) as one
    continuous curve sampled by shared-motion events, re-anchored by incidental
    everyday motion (no user gesture), tracked with sliding-window LSQ or a
    Kalman filter whose process noise sets a soft memory (not a hard validity
    window), and — since processing is offline — evaluated by interpolating
    between bracketing anchors rather than extrapolating. Notes where
    reconcile_nodes.py sits today and the upgrade path. Cross-link from §8.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
2026-09-01 Fix MULTINODE_SYNC_MATH equation rendering on GitHub
    Two source-level rendering bugs made the math illegible in GitHub's
    Markdown renderer (and its editor preview):
    - \tag{n} on the 11 display equations wraps each in a numbering table,
    which steals width and forces MathJax to line-break the body at every
    operator — the equation renders as a tall vertical stack. Replace
    \tag{n} with a trailing \quad (n): same visible number (so the "Eq. (n)"
    prose references stay valid) but no table, so equations render on one
    line like the untagged intro equation.
    - $\text{offset}$/$\text{drift}$ — two inline-math spans joined by "/" —
    the second span fails to parse and shows raw LaTeX. Me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
2026-09-01 Note trigger has no sensitivity knob; sensitivity vs idle-power coupling
    Record a constraint under "Coordinated trigger" that shapes any coverage
    fix (whether or not the shared trigger is built — that decision is left
    open): the wake/trigger runs off the BNO086 Stability Detector/Classifier,
    which emits a discrete Stable/Motion classification with no exposed numeric
    threshold. Getting a tunable sensitivity knob requires computing a software
    angular-speed metric, which needs fusion (gyro) running and cannot hold
    devSleep — so trigger sensitivity and idle power are coupled; the cheap
    accel-only path is exactly the one with no threshold. Lists the cheap
    coverage mitigations that need no kno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
2026-09-01 docs: update current-draw figures and de-question thought-process notes
    Current consumption:
    - Document the shipping firmware's real draw: ~12 mA in IDLE (hub-awake,
    accel-only detector) and ~22 mA while ACTIVE recording (full fusion).
    - Drop devSleep as a documented low-power option; keep only that it was
    explored and dropped because it suppressed the detector's motion wake.
    Updates IDLE_WAKE_SOURCE.md, FINDINGS.md, MULTINODE_SYNC_DESIGN.md.
    Thought-process docs (Task 2):
    - Rework question-driven passages so they read standalone, keeping the
    technical substance. Reframes the §11 headings/intro in
    MULTINODE_SYNC_MATH.md and the "compare the performance" heading in
    IDLE_WAKE_SOU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
2026-09-01 docs: tighten thought-process notes, cut redundancy
    - FINDINGS.md: fold the duplicated fusion-engine restatement into a single
    sentence, trim the "fits every result" list to its one non-redundant point
    (the report-rate check), and retie the probe "silver lining" to the
    i2cBusRecover mitigation instead of the retracted I²C-reset theory.
    - MULTINODE_SYNC_MATH.md §11: shorten the "validity window" and "partial
    participation" prose (the estimator-memory detail lives in §11.4/§11.5).
    - MULTINODE_SYNC_DESIGN.md: replace the per-platform connection-interval how-to
    with a pointer to MULTINODE_TESTING.md, which already covers it.
    - IDLE_WAKE_SOURCE.md: merge a duplicated "like the detec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
2026-09-01 docs: consolidate math §11 and the design doc's connection-interval story
    - MULTINODE_SYNC_MATH.md §11: collapse six subsections into three. 11.1 now
    carries the model plus the two "offset/drift" clarifications; 11.2 merges the
    former incidental-re-anchoring, estimator-memory, and interpolate-don't-
    extrapolate sections into one "getting and combining anchors" flow; 11.3 is
    the code/upgrade path. All content kept; §11.x cross-refs updated.
    - MULTINODE_SYNC_DESIGN.md: merge the "Finding" and "Confirmed on iPhone"
    sections (hypothesis + confirmation + consequences) into one block with the
    same numbers, and point the "Open risks" central-platform item back to it
    instead of rest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
2026-09-01 Refactor: remove dead defines and fix stale firmware comments
    Dead code:
    - Remove unused DETECTOR_ENTERED define (only DETECTOR_EXITED is used;
    ENTERED is explicitly ignored in handleIdle()).
    - Remove unused DETECTOR_INTERVAL_MS define (superseded by
    IDLE_DETECTOR_INTERVAL_MS / _US, which are the values actually armed).
    Stale/misleading comments:
    - Rewrite the IDLE_WAKE_SOURCE rationale block so it matches the active
    selection (DETECTOR), instead of reading as justification for CLASSIFIER
    while the code selects DETECTOR.
    - Document control command 0x06 (range resend / gap recovery) in the
    top-of-file command list and offload-protocol note, and correct the note
    to reference the c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
    [firmware.ino]
2026-09-01 Remove BNO devSleep path entirely (proven to suppress motion wake)
    Bench testing concluded the hub's own devSleep coalesced the Stability
    Detector's EXITED wake event, so IDLE→ACTIVE frequently never fired on
    motion (see IDLE_WAKE_SOURCE.md, "devSleep was explored and dropped").
    It survived only as a dormant, default-off A/B knob. Removing it:
    - Delete DETECTOR_DIAG_NO_DEVSLEEP, the IDLE_USE_DEVSLEEP computation,
    the IDLE_WAKE_WAKEUP_EN / IDLE_WAKE_ALWAYSON_EN flags, and the
    microsecond-only IDLE_DETECTOR_INTERVAL_US constant.
    - Drop the sh2_setSensorConfig() wake/always-on arming branch in
    enableIdleReports(); all sources now arm via enableReport() hub-awake.
    - Drop the modeSleep()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
    [firmware.ino]
2026-09-01 docs: correct IDLE_WAKE_SOURCE default in IDLE_WAKE_SOURCE.md
    The switch example and comparison table still labelled CLASSIFIER as the
    default ("new default"); the firmware default is IDLE_WAKE_DETECTOR. Update
    the code snippet and the table header to match.
    Claude-Session: https://claude.ai/code/session_018VhvoNCsrHamF1s7rnKBpW
2026-09-01 docs: record measured SIGMOTION idle tradeoff (keep as A/B option)
    Bench testing IDLE_WAKE_SIGMOTION: idle base current ~8mA (lower than the
    Stability Detector's ~12mA — the one-shot event means no ~1Hz detector
    heartbeat waking the nRF), but it is less sensitive to slow, gradual
    movement, so gentle motion can wake IDLE->ACTIVE late.
    - Replace the speculative "may fire more reliably" framing in the Section 3
    and top-of-file comments with this measured lower-power / lower-sensitivity
    tradeoff.
    - Add SIGMOTION as a third bullet in the IDLE state description; the detector
    is no longer labelled "lowest power" (SIGMOTION is), but is noted as the
    most sensitive to slow motion.
    - IDLE_WA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
    [firmware.ino]
2026-09-01 Revise idle current and sensitivity descriptions
    Updated idle current and slow-motion sensitivity values for clarity.
2026-09-02 firmware: power optimizations (DC/DC, IDLE-gated adv, report-rate match) + GRV A/B
    Non-coordinated-trigger power work. None of these change the recorded
    20-byte quaternion record format or the state-machine logic.
    - Enable the nRF52840 internal DC/DC (buck) regulator (NRF_POWER->DCDCEN)
    in setup(): more efficient than the default LDO across every state,
    most of all with the radio active.
    - BLE advertising made cheap and IDLE-only: slow the advertising interval
    to ~1s (offload is occasional and IDLE-only), and stop advertising in the
    RUNNING states (offload is rejected outside IDLE anyway), re-advertising
    on IDLE entry. Adds a bleReady guard for the advertise()/stopAdvertise()
    ca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
2026-09-03 docs: record measured power results; reframe GRV as data-quality not power
    Bench measurements after the optimizations (DETECTOR idle wake source):
    IDLE ~12 -> ~9 mA (DC/DC + gated/slow advertising), ACTIVE ~22 -> ~20-21 mA
    (DC/DC + report-rate match). GRV vs RV shows no meaningful power difference
    (gyro + fusion engine dominate; the magnetometer is comparatively cheap), so
    the GRV A/B switch is documented as a data-quality option, not a power lever.
    Claude-Session: https://claude.ai/code/session_018hFHwhcGXkgvwiuLjudBs1
2026-09-03 firmware: park external flash in deep power-down during IDLE; trim comments
    - Add qspiSleep()/qspiWake() (P25Q16H deep power-down 0xB9 / release 0xAB via
    QSPI cinstr). Park the chip in unconnected IDLE (which never touches flash)
    and wake it before any access: on BLE connect (offload/erase are control
    commands), at the top of applyPendingTransition() for the header write, and
    at end of setup(); re-park on IDLE entry and on disconnect back into IDLE.
    Expected saving is small (serial-NOR standby ~tens of uA vs ~9mA idle) — the
    larger related saving is deactivating the nRF QSPI peripheral (backlog).
    - Trim firmware.ino comments whose rationale/findings now live in
    POWER_OPTIMIZA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
2026-09-03 firmware: add nRF QSPI peripheral deactivation as second IDLE flash power-down layer
    Layer 2 on top of the external-chip deep power-down: on IDLE park, uninit the
    nRF52840 QSPI peripheral (nrfx_qspi_uninit) — a used-but-enabled QSPI block can
    keep the MCU drawing ~hundreds of uA, the larger of the two flash-side idle
    costs. On wake, re-init the peripheral FIRST, then release the chip (0xAB), then
    re-assert the one-time WREN a fresh init expects. Gated by
    QSPI_DEACTIVATE_PERIPHERAL (default on) so it can be disabled instantly.
    Unvalidated on hardware — needs the bench checklist in POWER_OPTIMIZATION.md
    (logging, offload, erase all survive a sleep/wake cycle; measure the idle delta
    with t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
2026-09-03 firmware: disable QSPI peripheral deactivation by default (nRF52840 Errata 122)
    Bench result: enabling QSPI_DEACTIVATE_PERIPHERAL raised idle ~9mA -> ~11mA
    (active unchanged within noise). Cause is nRF52840 Errata 122 — a disabled QSPI
    peripheral leaks ~1-2mA unless Nordic's errata register workaround is applied,
    which the Seeed mbed core's nrfx does not do, so nrfx_qspi_uninit() costs current
    instead of saving it.
    Set QSPI_DEACTIVATE_PERIPHERAL = 0 (layer 2 off). Layer 1 (external chip deep
    power-down) stays on — harmless. The layer-2 code and wake ordering are kept,
    gated off, so it can be revisited only with the Errata 122 workaround in place
    and re-measured. Record the finding in PO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
    [firmware.ino]
2026-09-03 firmware: remove QSPI peripheral-deactivation code; keep only chip deep power-down
    The peripheral-deactivation path (nrfx_qspi_uninit + re-init, the
    QSPI_DEACTIVATE_PERIPHERAL flag, qspiPeripheralInit/qspiSendWREN helpers, and the
    #if branches in qspiSleep/qspiWake) is gone for readability. It measured worse on
    this core (nRF52840 Errata 122) and was already disabled, so there's no reason to
    keep dead branches in the flash path. The finding stays recorded in
    POWER_OPTIMIZATION.md. qspiSleep/qspiWake now just do the external-chip deep
    power-down (0xB9 / 0xAB).
    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
    [firmware.ino]
2026-09-03 firmware: Tier B — run STATIC fusion vector at a slow (1Hz) rate
    STATIC_POSTURE logs only 0.2Hz but, even after Tier A, ran the fusion
    vector at the ACTIVE 10Hz rate — ~50 reports read and discarded per
    logged sample, each a wasted I2C read + nRF wake. STATIC now arms the
    fusion vector at BNO_RV_STATIC_INTERVAL_MS (1000ms, ~1Hz), cutting those
    RV wakeups ~10x while still giving 5 orientation samples per logged
    snapshot (posture at most ~1s stale — negligible for a static hold).
    The Stability Classifier is untouched: it keeps running at
    ACTIVE_STABILITY_MS (500ms) in both RUNNING states, so it (not the RV)
    still drives every transition and motion detection out of STATIC is
    unchanged. R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
    [firmware.ino]
2026-09-03 firmware: remove Significant Motion (0x12) idle wake-source option
    SIGMOTION was carried as a third IDLE_WAKE_SOURCE on the belief it was the
    lowest-power idle (a single node-level bench read: ~8mA vs the detector's
    ~12mA). The BNO086 datasheet (Fig 6-18) shows the opposite at the sensor
    level: Significant Motion draws ~0.48mA vs the Stability Detector's
    ~0.06mA — ~8x more, with the detector sitting essentially at the idle
    floor. So SIGMOTION has no chip-level power advantage; the bench gap was a
    system effect (no ~1Hz heartbeat waking the nRF), not a cheaper sensor.
    Against a non-existent power win it is also less sensitive to slow,
    gradual movement and can miss stretches — a data-loss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
    [firmware.ino]
2026-09-03 docs: correct the unsubstantiated ~8mA SIGMOTION idle figure
    The ~8mA SIGMOTION idle current cited in the wake-source docs traced to an
    earlier AI-authored docs commit (8c47aca) that recorded it as "bench
    tested" but was never reproducible. Per the hardware owner, the best
    SIGMOTION reading actually taken was ~11mA on the unoptimized code — only
    ~1mA under the unoptimized detector's ~12mA, and never re-measured after
    the DC/DC optimization. A ~1mA gap (not ~4mA) is also what removing a 1Hz
    heartbeat should look like, and matches the datasheet showing the detector
    is the cheaper sensor. Correct both POWER_OPTIMIZATION.md and
    IDLE_WAKE_SOURCE.md to the ~11mA figure and flag the ~8mA as unrep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
2026-09-03 firmware: restore SIGMOTION idle wake option; record real findings
    Fresh bench data reversed the earlier drop decision: on the optimized
    build SIGMOTION idles ~7.4mA vs the detector's ~9mA — a real ~1.6mA (~18%)
    saving, not the phantom ~8mA. Restore IDLE_WAKE_SIGMOTION as the third
    compile-time wake option (define, SH2_SIG_MOTION id, Section 3 name branch,
    handleIdle one-shot branch) so it can be A/B tested.
    DETECTOR stays the default: bench testing shows SIGMOTION fires on
    shake/drop but NOT on a slowly stretched held arm. That is a signal
    mismatch, not a tunable threshold — Significant Motion thresholds motion
    ENERGY (fixed Android semantics) and a slow stretch is low-energy, so
    lower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
    [firmware.ino]
2026-09-04 docs: soften the yaw blind-spot claim; add detector-drop-heartbeat option
    The earlier "yaw needs gyro" caveat was overstated. For a body-worn
    (off-axis) sensor even a horizontal limb swing produces linear
    acceleration (centripetal + start/stop transients), and an on-change
    accelerometer watches the whole accel vector, not just gravity direction —
    so it catches both a slow tilt and movement transients, the same two
    channels the accel-only Stability Detector already uses to catch stretches.
    The genuine blind spot is the pathological pure-yaw-on-axis case, which
    doesn't occur on a limb. Reframe the backlog item around the real goal
    ("detector sensitivity minus the ~1Hz heartbeat"), add the
    de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
2026-09-04 firmware: experiment — drop detector heartbeat (IDLE_DETECTOR_QUIET) + reset logging
    Test whether making the Stability Detector silent-when-still lowers idle
    current toward SIGMOTION's ~7.4mA WITHOUT SIGMOTION's slow-motion blind
    spot (the detector still fires EXITED on a slow stretch). IDLE_DETECTOR_QUIET
    (default 1) stretches the detector report interval to 60s so the ~1Hz
    heartbeat is effectively gone while EXITED still fires immediately on motion;
    flip to 0 to A/B against the original ~1Hz heartbeat.
    The prior warning that a stretched interval worsens the ~6.5s self-reset
    (toward the ~1s floor) and drops motion wakes dates from the removed
    devSleep path, so re-test it hub-awake rather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
    [firmware.ino]
2026-09-04 firmware: make detector on-change (no heartbeat) permanent; docs to validated facts
    Bench results (optimized build, DETECTOR): dropping the ~1Hz heartbeat
    (detector reported on-change, 60s keepalive) trims idle ~9 → ~8.8mA with
    the ~6.7s self-reset cadence and slow-motion sensitivity both unchanged.
    Removed the IDLE_DETECTOR_QUIET A/B toggle and set the detector interval to
    the on-change value permanently; kept the ms-since-last-reset log as a field
    diagnostic.
    Also validated: the SIGMOTION build prints NO reset lines — it does not run
    the detector's ~6.7s self-reset, which is the ~1.4mA it idles below the
    detector (~7.4 vs ~8.8mA). The reset is inherent to a non-fusion continuous
    senso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
    [firmware.ino]
2026-09-04 Revise POWER_OPTIMIZATION.md for clarity and updates
    Updated the POWER_OPTIMIZATION.md document to clarify power work on firmware and removed outdated measured results section.
2026-09-04 firmware: rename SH2_SIG_MOTION to canonical SH2_SIGNIFICANT_MOTION
    The IDLE Significant Motion wake source used a private symbol name,
    SH2_SIG_MOTION, that no library defines. The sh2 driver bundled with
    SparkFun_BNO08x names this report SH2_SIGNIFICANT_MOTION (an enum member
    in sh2.h / sh2_SensorId_e, value 0x12), so searches for the symbol found
    nothing and the local #ifndef fallback always supplied the value.
    Rename all three sites (the guarded define plus the IDLE_WAKE_SENSOR_ID
    and handler uses) to the canonical name. Value is unchanged (0x12,
    verified against the driver enum) and the change is functionally a no-op
    since the report ID is passed through enableReport(), but the name now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
2026-09-04 docs: correct SIGMOTION threshold claim, flag tuning as future investigation
    Earlier notes described the Significant Motion detector's trigger as a
    "fixed, non-exposed motion-energy threshold." That is inaccurate: the sh2
    driver defines an FRS configuration record SIG_MOTION_DETECT_CONFIG
    (0xC274) holding an acceleration threshold and a timeout/window. The
    threshold exists and is documented — it is just not writable through the
    SparkFun library, which exposes no FRS-write path.
    Correct the claim in firmware.ino (Section 3) and POWER_OPTIMIZATION.md,
    and add a "Tuning SIGMOTION sensitivity" section to IDLE_WAKE_SOURCE.md
    capturing what was found (record 0xC274, no library FRS-write, the
    se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
    [firmware.ino]
2026-09-04 Add montage schema + capability resolver for motion analysis
    Introduces the layer between the aligned multi-node stream and upper-extremity
    biomechanics: a declarative "montage" (which node sits on which body segment,
    plus calibration state) and a resolver that reports which joints and metrics a
    given placement can actually compute — and which are blocked, and why.
    Rationale: an IMU node measures SEGMENT orientation, not a joint. A joint angle
    (what ROM quantifies) is the relative orientation of two adjacent segments'
    nodes, so the computable metric set is a function of node placement. The
    resolver makes that dependency explicit instead of silently emitting a wrong
    number when a required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
2026-09-04 Add bilateral activity asymmetry + node landmark labels
    Closes the gap the sparse two-node cases exposed: a left/right comparison had
    no way to surface because symmetry was defined only at the joint tier.
    - Bilateral activity asymmetry: a new derived capability
    `activity_asymmetry_<base>` fires on any matching L/R SEGMENT pair
    (upper_arm / forearm / hand) — one node each side, no joint or torso needed.
    It answers "which arm is used more" via session-aggregate metrics
    (asymmetry_index, use_ratio, active_time_ratio) that do not require the two
    sides to be time-aligned, so the number stays valid even when reconcile
    aligns independently-moving limbs with low confidence.
    - Node la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
2026-09-04 Add pipeline walkthrough visual (design reference)
    A self-contained, theme-aware HTML walkthrough of the full analysis pipeline —
    capture → offload → reconcile → montage/resolve → calibrate → metrics →
    interface — marking what is built vs planned and the data shape handed off at
    each boundary. Includes the sparse two-node worked example (bilateral activity
    asymmetry surviving where joint ROM cannot form). Reference/design doc, not
    part of the runtime path.
    Claude-Session: https://claude.ai/code/session_012MztYyJYgui45KkLKSvus2
2026-09-08 Record setup/calibration design decisions in planning docs
    Captures the decisions from the design discussion on node identity, the
    time-vs-mounting distinction, calibration lifecycle, and the free-body diagram.
    - SETUP_AND_CALIBRATION_PLAN.md (new): planning doc for pipeline stages 5-7.
    Anchors on firmware facts (mag-referenced full Rotation Vector → shared world
    frame; per-boot millis clock). Decisions: persist the segment as a 1-byte log
    header (self-describing offloads, montage auto-populated); config separate
    from calibration; time offset vs mounting calibration are distinct quantities
    with distinct lifetimes (time = per power-up, not cacheable; mounting = per
    don, cache-a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
2026-09-08 Add stage-5 calibration tool (sensor→segment solve, cache-and-verify)
    Implements the first item in SETUP_AND_CALIBRATION_PLAN.md's build order:
    the sensor→segment mounting solve that gates every clinical angle/ROM number.
    tools/calibrate_segments.py, three subcommands:
    - calibrate: reads the reconcile aligned.csv + a montage, solves each node's
    mounting offset (q_SB = conj(q_neutral) ⊗ q_target) over the neutral-pose
    window via Markley quaternion averaging, and emits calibration.json. Alongside
    each offset it caches a heading-independent consistency baseline — per-segment
    gravity-in-bone-frame (isolates a single node's slip; invariant to which way
    the subject faces) and p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
2026-09-09 docs: add plain-language calibration explainer + placement note
    - §4: a high-level "in plain terms" paragraph (the crooked-compass framing)
    next to the math, so the intent reads before the quaternion detail.
    - §2.3: record that the mounting offset absorbs fixed anatomical tilt (e.g. the
    chest node's sternum slope), so placement needs to be repeatable rather than
    anatomically aligned; and that constraining arm nodes to a landmark-referenced
    sagittal pocket pins down the fragile axial-roll DOF without changing the solve.
    Claude-Session: https://claude.ai/code/session_01JSzwhTdHovvNXgPAC5JuFx
2026-09-09 Add floating-segment FBD viewer (stage-7 segment tier)
    Build order item 2 in SETUP_AND_CALIBRATION_PLAN.md: the first, cheapest
    visual, and the one that validates stages 5-6 with your eyes.
    tools/floating_fbd.py bakes the reconcile stream (+ an optional
    calibration.json) into a single self-contained HTML viewer. Each placed
    segment is drawn as its own oriented bar floating at a fixed slot, driven
    directly by its measured quaternion -- orientation is measured, position is
    deliberately not (the bodies float apart; connection is modeled, and comes in
    the later joint/chain tiers).
    The raw<->calibrated toggle is the payoff: the viewer applies the cached
    mounting offset on the fly (q_seg = q_WS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
2026-09-09 Add connected-skeleton (stickman) layout to the FBD viewer
    Answers "we know how torso/upper-arm/forearm connect anatomically -- can we
    use that?" with the chain tier from SETUP_AND_CALIBRATION_PLAN.md §5, added as
    a second layout in the same viewer (toggle Skeleton <-> Floating).
    Skeleton connects the segments by forward kinematics: root the torso, place
    each child's proximal end at its parent's joint (the torso carries shoulder
    sockets; other parents hand off at their distal tip), orient each bone by its
    measured quaternion, step down the chain. Drawn as a stickman -- thin bones,
    white joint dots, a head above the torso.
    Honesty preserved and made explicit:
    - The CONNECTIVITY is real: th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
2026-09-09 Handle no-torso bilateral case in the skeleton layout
    The sparse left+right montage without a torso (the "which arm is used more"
    asymmetry case) previously rendered as two arm-chains floating at nominal
    shoulders with an empty gap between them -- honest, but it didn't read as one
    body.
    - When the torso node is absent but both upper arms are placed, draw a fixed
    dashed "shoulder girdle" bridging the two nominal shoulder roots, labeled
    "torso -- not measured". It's static (a fixed assumed frame, not measurement)
    and clearly marked, so the two arms read as one figure without faking a trunk.
    - Default to the Skeleton layout for this case too (new meta.skeleton_default:
    torso present, O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
2026-09-09 Bridge missing-middle segments with dashed ghost bones (skeleton)
    Handles the case of a torso + forearm with NO upper arm (a gap in the middle
    of the kinematic chain). Previously the forearm had no placed parent, so it
    fell to a floating anchor and read as disconnected.
    Now the FK walks the FULL anatomical chain (new baked `anat_chain`, presence-
    independent, from motion_capabilities.JOINTS), not just present-parent links:
    - Each link is placed at its parent's hand-off socket and oriented by the
    parent's MEASURED quaternion when that node exists, or by identity (a ghost
    "at rest") when the node is missing.
    - A present bone is always solid (orientation is real); a missing middle
    segme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
2026-09-09 Skeleton: torso facing auto-correction + flag uncalibrated bones
    Two fixes for the connected-skeleton view, both zero extra burden at capture.
    1. Facing (heading) auto-guess from the torso. The mag-referenced world gives
    orientation but not how the subject's forward lines up with north, so a
    forward reach could draw sideways. calibrate_segments.compute_heading now
    recovers the facing from the torso's neutral orientation under one coarse,
    documented assumption (TORSO_FORWARD_IN_SENSOR = which sensor axis points out
    of the chest) and writes a `heading` block into calibration.json. It
    self-checks: the assumed forward axis must land ~horizontal at the upright
    neutral pose a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
2026-09-11 Skeleton: anthropometric arm/forearm lengths (shorter, proportioned)
    The skeleton's bone lengths were eyeballed, and the arm hung below the pelvis.
    Set the arm segments from Winter's segment-length/stature ratios (upper arm
    0.186, forearm 0.146, hand 0.108 of stature) at a nominal stature constant STAT,
    so they are realistically proportioned and noticeably shorter (upper arm
    0.30->~0.26, forearm 0.26->~0.20, hand 0.18->~0.15). Torso stays ~0.50 so the
    shoulder sockets, root, grid and camera keep their tuning; STAT rescales the
    limbs together. Only affects where bars are drawn, never the measured
    orientation.
    Claude-Session: https://cla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
2026-09-11 Skeleton: whole figure from anthropometry (torso, shoulders, head)
    Replace the eyeballed per-segment sizes with one anthropometry table: every
    segment's length and breadth is a fraction of stature (Winter), so the figure is
    one consistent body. Key results:
    - Torso breadth = biacromial (shoulder) width, drawn as a shoulder bar spanning
    the two sockets that swings with the trunk, so the shoulders read at real
    width and the arms hang from their ends.
    - Head is sized (0.13 stature) and offset by a neck gap so it clears the
    shoulders, instead of a fixed magic radius.
    - Arm/forearm/hand lengths and thicknesses all come from the same ratios; one
    STAT constant rescales the whole body.
    - Re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
2026-09-11 Skeleton: draw the torso as one trapezoid (fix "two torsos" look)
    The previous torso was two overlapping thick blue capsules — a vertical trunk
    tube plus a horizontal shoulder bar — which read as two separate torso segments.
    Replace both with a SINGLE filled trapezoid: narrow at the hips (bi-iliac
    breadth), wide at the shoulders (biacromial breadth), tilting/twisting with the
    trunk. Arms hang from its top corners; the head sits a neck's gap above the
    shoulder line. Drawn before the limbs so raised arms overlay it. Torso is skipped
    in the bone, joint-dot and label passes now that the trapezoid represents it.
    Reads as one body in both neutral and motion; selftest passes; no errors.
    Co-Au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
2026-09-11 Skeleton: render as solid shaded 3-D volumes (not flat ribbons)
    The skeleton was already 3-D (real joint positions, perspective, orbitable) but
    drawn with flat primitives, so it looked flat. Now each limb is a solid oriented
    box, the torso a tapered 3-D block (wide shoulders, narrow hips, real depth),
    joints are rounded balls that fill the seams, and the head is a shaded ball.
    All faces are shaded by their normal and painted in one depth-sorted pass, so
    occlusion between torso and arms is correct. Added boxBetween/faceOf/ball
    helpers (reusing the floating view's face-shading approach). Lowered the
    shoulder sockets to 0.88 of torso height so the shoulders sit below the neck.
    Ghost (missing)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
2026-09-11 Skeleton: round/fillet the torso + add a neck to attach the head
    Two polish fixes on the solid 3-D figure:
    - The torso was a hard box, so a swinging arm cut into its sharp edges. Render
    it instead as the rounded, shaded convex-hull silhouette of its 3-D box
    corners, filleted with a round-join stroke and filled with a volume gradient —
    no sharp edges, and it still depth-sorts as one unit with the limbs.
    - The head floated a neck's gap above the shoulders. Add a short neck box from
    the shoulder line up to the head so they connect.
    selftest passes; full-body, no-torso and middle-gap render clean.
    Claude-Session: https://claude.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
2026-09-11 Skeleton: unified rounded-capsule figure, head seated on the body
    Reworked the skeleton to one consistent rounded look (fa-person vibe):
    - Every limb is now a shaded CAPSULE (round-capped bar with a cylindrical
    highlight gradient) instead of a hard box, so all segments share the same
    rounded cylindrical feel and joints merge smoothly (no separate joint balls).
    - The torso stays a rounded, filleted, volume-shaded blob.
    - The head is a ball seated directly on the shoulders (its base overlaps the
    torso), so it reads as attached — the separate neck box is gone.
    - All parts (torso, capsules, head, dashed ghosts) go through ONE depth-sorted
    pass so nearer parts cover farther ones.
    Ghost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
2026-09-11 Revert skeleton to the first solid-3D (shaded box) rendering
    Per preference, restore the skeleton renderer to commit 4fc6390 — solid shaded
    3-D boxes for the limbs, a tapered 3-D box torso, rounded joint balls and a ball
    head — dropping the later rounded-torso/neck (6b7559f) and capsule (17ba447)
    iterations. Only tools/floating_fbd.py is affected; calibration, docs and all
    other behavior are unchanged. selftest passes; full-body renders as before.
    Claude-Session: https://claude.ai/code/session_01WnEJNGU2GqLrZwQLsixQin
2026-09-11 Blend joint-ball colors from the two connected segments
    Each joint links two bones, so its ball now averages their colors —
    shoulder = torso + arm, elbow = upper_arm + forearm, wrist = forearm +
    hand. Leaf tips (fingertips, or a forearm end with no hand node) keep
    their own segment color. Replaces the previous per-segment double ball
    (prox + dist both in the segment's own color) with one blended ball at
    each real joint plus a single own-color tip only where a limb ends.
    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
2026-09-14 Tolerate a UTF-8 BOM when reading montage/calibration JSON
    Windows Notepad ('Save as UTF-8') and PowerShell's '>' redirect prepend a
    byte-order mark. Opening those files as plain text left the BOM as a stray
    character at position 0, so json.load crashed with the opaque
    'Expecting value: line 1 column 1 (char 0)' before ever reaching the '{'.
    Read montage and calibration JSON with encoding='utf-8-sig', which strips a
    leading UTF-8 BOM if present and is a no-op otherwise.
    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
2026-09-17 Add data collection checklist (capture -> reconcile -> visualize)
    A run-sheet covering the full session capture flow: erase, power/identify
    nodes, strap, sync/clock-check while still, record the movement with the
    laptop disconnected (nodes log to flash autonomously on motion), offload both
    logs, reconcile in montage-column order, then the post-reconcile
    capability/calibrate/visualize chain. Includes the 2-node elbow montage as the
    worked example and a troubleshooting table for the issues seen in practice
    (slow Windows offload, BOM'd montage JSON, low reconcile confidence).
    Claude-Session: https://claude.ai/code/session_01WnEJNGU2GqLrZw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
2026-09-17 Streamline testing: node enrollment + one-shot post-offload pipeline
    Two ergonomics tools that remove the friction of bench testing without touching
    the accuracy path:
    - setup_nodes.py: one-time shake-to-assign enrollment. Scans nodes, turns on the
    firmware debug quaternion stream (control 0x01/0x00, char A001) as a bench-only
    step, and for each segment you shake the board you're about to strap there; it
    reports the moving id, captures a physical label, and writes a schema-valid
    montage.json plus a persistent nodes_registry.json. --reuse rebuilds the
    montage from the registry with no shaking when the same (permanent-id) boards
    are present. Solves 'which board goes where' offline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
2026-09-17 Fix setup_nodes shake capture: listen during asyncio sleep, require sustained motion
    The shake window was captured wrong: a blocking input('SHAKE...then Enter')
    froze the asyncio event loop, so BLE notifications were NOT processed while the
    user shook the board and the per-node peak stayed ~0 (only a 0.2s tail after
    Enter ever ran). Detection would be unreliable in practice.
    Fix:
    - Capture during an awaited asyncio.sleep(LISTEN_WINDOW_S) (yields to the loop,
    so A001 notifications accumulate) instead of during a blocking input().
    - Run operator prompts via run_in_executor so input() never blocks the loop.
    - Require SUSTAINED motion: a node must exceed MOVING_FLOOR_DPS for
    MIN_MOVED_SAMPL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
2026-09-17 Rework node enrollment: power-one-at-a-time instead of shake-to-identify
    The shake approach relied on the firmware's debug quaternion stream (A001), which
    is debug-only, would wake ACTIVE_RECORDING (logging junk to flash during setup),
    needs all nodes connected/streaming at once, and really wants a dedicated
    firmware setup mode to be robust. Not worth it now.
    Replace it with the simpler, firmware-free method: power ON one node at a time.
    With a single board advertising, its permanent id (HULC-IMU-XXXX) is unambiguous,
    so enroll scans, finds the one node, and assigns it to the segment being placed.
    --erase optionally wipes each node's flash in the same one-board-on pass (the
    pre-session eras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
2026-09-18 Merge enrollment into multinode_test.py (unified subcommands); drop setup_nodes.py
    Fold the power-one-at-a-time node enrollment + montage/registry builder into the
    existing BLE harness, and give both a single subcommand CLI:
    enroll --segments ... [--erase] [--reuse] power-one-at-a-time -> montage.json
    check --count 2 --duration 60 sync + cross-node offset/drift
    erase --count 2 wipe flash (destructive)
    offload --count 2 --out-dir ./capture [--erase-after]
    selftest offline logic, no hardware
    The legacy flag form (--erase / --offload / --count / --duration /
    --erase-after-offload) still works as a dep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
2026-09-18 Smart erase (skip-empty + y/N confirm); move erase back to session start
    Add smart_erase(): over an already-open connection, read the node's log size
    first and skip the ~30s wipe entirely when it's already 0KB; otherwise confirm
    before wiping (assume_yes wipes; an interactive prompt asks [y/N]; with neither,
    a node holding data is left in place, never wiped blind). The decision is a pure
    erase_decision() helper, unit-tested in selftest.
    Wired in two places, both reusing one connection:
    - enroll --erase: per-node connect now checks-then-(maybe)-wipes with a prompt,
    instead of unconditional erase.
    - erase subcommand: skips already-empty nodes and confirms per node; new --yes
    bypasses the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
2026-09-18 Cleanup: remove dead code, fix lint, align docs to subcommands
    - calibrate_segments.py: drop unused SEGMENTS import; remove dead `corr` local
    in the heading selftest.
    - floating_fbd.py: drop unused WORLD_UP import.
    - multinode_test.py: fix three f-strings with no placeholders (plain strings).
    - MULTINODE_TESTING.md: use the subcommand form (offload --erase-after / erase)
    to match the rest of the doc; note erase's per-node confirm + --yes.
    pyflakes is now clean across tools/, all six tool selftests pass, everything
    compiles.
    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
2026-09-18 Tighten .gitignore; consolidate tools/.gitignore into root
    Replace the broad `*.json` (which would swallow future intended JSON) with the
    specific per-session generated names — montage.json, nodes_registry.json,
    calibration.json — so tools/montage.example.json and any future config stay
    tracked. Keep the broad `*.html` for generated viewers (names vary by --out) but
    un-ignore the tracked doc page. Fold the Python-cache rules from
    tools/.gitignore into the root file and delete the redundant second .gitignore.
    Verified: tools/montage.example.json and tools/pipeline_walkthrough.html are not
    ignored; montage.json / nodes_registry.json / calibration.json / aligned.csv /
    generated *.html / ca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
2026-09-18 Checklist: make the data-safety rationale for erase-at-start explicit
    Erasing before each recording (vs offload --erase-after) keeps the previous
    session's raw capture on the node until the next session deliberately begins —
    recoverable if a transfer was subtly bad, files are lost, or an analysis needs
    redoing from raw. Spell this out in the mental model, step 2, and the
    --erase-after note (now framed as "discards the on-device raw immediately; use
    only when that backup isn't worth the connect"). Also clarify erase is a BLE op,
    so strapped-on boards never need unmounting to be wiped.
    Docs only.
    Claude-Session: https://claude.ai/code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
2026-09-18 Self-describing logs: node segment header + montage auto-populate
    Each node now records which body segment it is on, so an offloaded log says
    which body PART, not just which node — closing the mislabel-after-offload risk
    (SETUP_AND_CALIBRATION_PLAN.md step 3, §2.1/§2.2).
    - Store the segment as a config-tag + 1-byte code in the log header's reserved
    bytes (persists across power cycles and log erases; legacy headers read as
    unassigned, never guessed as torso).
    - Control command 0x07 sets it; the status characteristic (now 6 bytes) reports
    it back.
    Host:
    - motion_capabilities.py: SEGMENT_CODES is the one enum shared with firmware,
    with segment_from_header(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
2026-09-18 Stage-6 metrics: per-DOF joint angles + range of motion
    Build step 4 (SETUP_AND_CALIBRATION_PLAN §6): the payoff stage over the
    calibrated stream. metrics.py applies the cached mounting offsets, forms the
    distal-relative-to-proximal quaternion for every computable joint, and
    decomposes it in the joint's declared ISB/Wu Euler sequence to read each
    clinical DOF's angle series, ROM (min/max/range/median), and peak velocity —
    plus calibration-free segment angular speed.
    - DOF.seq_index added to the body model as the single source of truth for which
    Euler slot each clinical angle occupies (a 2-DOF joint drops the unused slot);
    the resolver selftest now guards it against the declared seque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
2026-09-18 Complete the stage-6 metric tiers: velocity, reps, segment + derived
    Extends metrics.py from ROM-only to every metric the resolver declares, each
    emitted only when resolve() says the montage supports it and carrying the same
    clinical/relative-only honesty flag:
    - joint: per-DOF angular velocity (peak/mean/RMS) and repetition count
    (hysteretic midline crossings, calibration-free).
    - segment: angular travel + active-time fraction, elevation from vertical,
    movement smoothness (SPARC spectral arc length), and a time-weighted
    posture-dwell histogram (calibration-gated).
    - derived: L/R ROM symmetry, bilateral activity asymmetry, inter-joint
    coordination (normalized cross-correlation + lag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
2026-09-18 Checklist: sensor-placement guidance (one principle, per-segment sites)
    Add a "where on each segment" subsection to step 1. Frames placement around the
    single rule that optimizes both soft-tissue artifact and re-don repeatability —
    place over the least contractile tissue, referenced to a bony landmark, with
    axial roll pinned — and notes the static offset is calibrated away, so
    repeatability (not alignment) is the goal.
    Per-segment: torso anterior/sternum, upper arm lateral distal-third, forearm
    lateral/dorsal over the ulnar border, hand on the dorsum. Calls out that anterior
    torso specifically is what the heading recovery assumes
    (TORSO_FORWARD_IN_SENSOR), so it is not just a repeatabil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
2026-09-18 Stage 7 review UI: fold metrics into the FBD viewer
    floating_fbd render now takes --metrics metrics.json and bakes a review
    panel beside the 3-D body, so the whole stage-7 review is one
    self-contained page (still no external scripts/CDN):
    - Joints: per-DOF ROM (range + min…max) and peak/mean velocity, rep
    counts, and the decomposition. Singular DOFs read "singular" with the
    guard note; a blocked joint names its missing node.
    - Segments: travel, active-time %, elevation range, peak speed, SPARC.
    - Derived: the resolver-unlocked tier (symmetry / asymmetry /
    coordination / compensation) with its per-metric note.
    The honesty flags carry straight through the UI: a clinical:false joint
    r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
2026-09-18 Write the review HTML as UTF-8 (fix Windows cp1252 crash)
    The baked page is <meta charset="utf-8"> and carries non-ASCII glyphs
    (↔, °, ·, —) in the metrics panel. open(out, "w") uses the platform
    default encoding, which on Windows is cp1252 and cannot encode U+2194,
    so `render` died with UnicodeEncodeError mid-write. Pin both HTML writes
    (cmd_render + selftest) to encoding="utf-8". Reads already use utf-8-sig.
    Claude-Session: https://claude.ai/code/session_017XQ3AKGLQEenxzq7Ke2Y3x
2026-09-19 Docs: mark stages 5-7 built; fix pipeline-order drift
    The pipeline walkthrough still showed Calibrate as "Next up" and
    Metrics/Interface as "Planned" — all three shipped over the last PRs.
    Refresh it:
    - All seven stages read "Built"; the glance strip, rail states, header
    lede, "you are here" divider and footer updated to match.
    - Calibrate/Metrics/Interface cards rewritten to describe what actually
    exists: the tool that runs each (calibrate_segments.py, metrics.py,
    floating_fbd.py), emits blocks for metrics.json and the review page,
    and honest framing for the interface (post-hoc, offload-based — no
    live stream).
    SETUP_AND_CALIBRATION_PLAN.md: drop the stale "(next up: step 4)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
2026-09-19 Docs: add tools/METRICS.md — per-metric computation reference
    The computation of each metric lived only in metrics.py docstrings; the
    .md docs covered the catalog/gating but not the formulas. Add a standalone
    reference that pulls it together, one table per tier:
    - Joint: per-DOF angle, ROM, velocity, reps — with the shared
    quaternion→angle chain and the Euler singularity guard.
    - Segment: angular speed, travel + active fraction, elevation, SPARC
    smoothness, posture dwell.
    - Derived: L/R ROM symmetry, activity asymmetry, coordination, trunk
    compensation.
    Each row gives the method, units, calibration gate, and metrics.json
    field; plus the constants table, the output schema, and t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
2026-09-25 Decompose joint angles in anatomical axes, not world axes
    Calibration zeroed each segment at the neutral pose but left its axes on
    the world compass (Z = up), while the ISB/Wu Euler sequences assume
    anatomical axes. A pure elbow flexion therefore landed in the unreported
    slot or in pro_sup depending on which way the subject faced, and a
    forearm twist read as flexion.
    calibrate_segments now emits an `anatomical_frame` block (X anterior,
    Y superior, Z right) built from gravity and the subject's facing (torso
    heading, or the new --facing-deg for montages without a torso node).
    metrics re-expresses each joint's relative rotation in that frame before
    decomposing, and reports a joint as clinical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
2026-09-25 Relabel shoulder DOFs to ISB YXY terms; add a primary DOF per joint
    The shoulder's YXY slots were labelled flexion/extension, abduction/
    adduction and internal/external rotation, but they are plane of
    elevation, elevation and axial rotation: a 20° forward raise read as
    "abduction 20°" with "flexion -90°". Rename them (plane_elev, elevation,
    axial_rot) and document how plane of elevation reads.
    Joints can now declare a primary DOF (shoulder = elevation). Reps, L/R
    symmetry and coordination use it instead of whichever DOF swung most,
    which for the shoulder was often plane of elevation.
    Also document which torso-node mounting errors the facing recovery
    tolerates (pitch, roll) and which it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
2026-09-25 Use clinical shoulder conventions and matching left/right signs
    Left joints are now mirrored through the sagittal plane before the Euler
    split, so every DOF has the same clinical sign on both arms (flexion,
    pronation, ulnar deviation, internal rotation positive). Previously the
    shared anatomical frame flipped abduction and axial-rotation signs on the
    left.
    Shoulder YXY angles are read on ISB's negative-elevation branch, so
    plane of elevation is 0° for abduction and +90° for forward flexion while
    elevation stays positive. Axial rotation is reported as plane + ISB axial
    angle: the ISB third angle alone trades with the plane (20° of internal
    rotation read -70° in forward flexion), whereas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
2026-09-25 Viewer: skeleton only, with the subject's front marked
    Remove the Floating layout (segments as bars at fixed slots), which was
    confusing; the skeleton handles every montage.
    Fix the skeleton facing backward: after the facing correction the
    subject's forward is +Y and their right +X, but the right shoulder was
    hung on -X, so a forward reach drew behind the figure. The shoulders are
    now placed on the subject's left/right from the calibration facing.
    Mark the front: a ground arrow labelled FRONT (BACK / L / R around it),
    a lighter chest face, a nose on the head, and Front / Side / Top camera
    presets. With no confident facing the arrow is dashed and reads
    "front? (facing unknown)". The facing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
2026-09-25 Rename floating_fbd.py to skeleton_viewer.py
    The Floating layout is gone, so the old name no longer describes the
    tool. Update the pipeline runner, docs and .gitignore comment, and
    switch the log prefix and default output name to match.
    Claude-Session: https://claude.ai/code/session_01DYHCfqiX3hYUmqp9GCwsot
2026-09-25 Viewer: make forearm rotation visible; add 2x/5x playback
    Limb boxes took their cross-section axes from a fixed world direction
    and were square, so twist about the long axis never showed: pronation
    and supination were in the data but invisible. Each box now rolls with
    its bone's own anterior axis. The forearm and hand are flat slabs with a
    lighter palm-side face and a thumb nub on the lateral side, so palm back
    / thumb in reads as pronated and palm forward / thumb out as supinated.
    A corner panel shows the live pronation/supination angle per forearm,
    computed as metrics.py does (anatomical frame baked into the scene, left
    arm mirrored, ZXY slot 2); it is blank in the raw view or when the fr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
2026-09-25 Fix viewer selftest for the forearm-rotation check
    The check required the self-test session to bake an anatomical frame,
    but that session's torso mounting correctly yields a low-confidence
    facing, so no frame is baked. Check a calibration with a stated facing
    instead, and that no frame is baked when the facing is not confident.
    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
2026-09-25 Make the coordination joint pair deterministic
    The coordination capability listed its joints by iterating a set of
    strings, whose order changes per process with hash randomisation.
    metrics.py compares the first two, so with shoulder, elbow and wrist
    all present the compared pair varied from run to run. List them in
    body-model order (proximal to distal) instead.
    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
2026-09-25 Viewer: plain-language header and a larger, cleaner metrics panel
    Header: "Session review" with subject, session, duration and sensor
    count, plus Calibrated / Front known status chips (details on hover).
    The stage label, long technical paragraph and file names are gone; the
    reading key moves into the right-hand box with the sensor list.
    Metrics panel: wider (440px) with larger type. Cards use plain names
    ("Right elbow", "Arm raise (elevation)"), signed ranges read in words
    ("from 70° supination to 70° pronation"), and comparisons are written
    out instead of raw keys. Anything not computed is left out: blocked
    joints, movements undefined for the whole session, empty values and
    empty section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
2026-09-25 Reconcile: save sync confidence and data gaps to aligned.quality.json
    Reconcile measured each sensor's clock-sync confidence and dropped
    records but only printed them, so nothing downstream could show how far
    to trust timing-sensitive results (metrics.json says to surface them).
    Write a sidecar next to the aligned CSV with, per node: offset,
    sync confidence and whether it passed the gate, record counts, and a
    data-loss summary within the overlap (share of time in gaps, longest
    gap, gap count; a gap is > 3x the median interval and >= 250 ms).
    The selftest checks the gap summary on a known 1.1 s hole.
    Claude-Session: https://claude.ai/c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
2026-09-25 Viewer: live angles for every joint, sync/gap warnings, labels on demand, colour by side
    - Live angles: the right-hand box shows the current angle of every
    joint with both sensors placed, computed like metrics.py (joint
    definitions baked into the page); matches metrics.py per sample to
    within 0.005 deg, including where an angle is undefined.
    - Sync and data gaps: header chips from reconcile's quality sidecar
    ("Sensors in sync" / "Sync low: <sensor>", "Data gaps: <sensor>"),
    sensor rows flag low sync or gaps, and joint and timing cards whose
    sensors are affected carry a warning. Older sessions show "Sync not
    recorded". The viewer finds aligned.quality.json next to the CSV or
    t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
2026-09-25 Viewer: angle-over-time graph
    Click a movement in the metrics panel to open a graph strip under the
    3-D view with that angle across the session: the same movement on the
    other side dashed for comparison, the playhead synced to playback,
    click or drag to seek, the neutral window and undefined stretches
    shaded, and min/max marked with up/down labelled (e.g. pronation /
    supination). Click the row again, Close, or Esc to hide it.
    The series is computed in the page from the baked quaternions with
    metrics.py's chain (calibrated stream, unwrapped, shifted into +-180 as
    the panel does), so no per-frame data is added to the file. Checked on
    a synthetic all-joints session: matches metrics.py per samp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
2026-09-25 Viewer: drop the data-gaps flag
    Remove the "Data gaps" header chip, the "data gaps" status on sensor
    rows and the data-gap note on joint cards. The sync chip and low-sync
    warnings stay. Reconcile still records gap statistics in
    aligned.quality.json; the page just no longer shows them.
    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
2026-09-25 Add OpenSense feasibility harness and partial-montage findings
    Synthetic-ground-truth evaluation of OpenSim 4.6 OpenSense (IMUPlacer +
    IMU IK, Rajagopal2015 model) against our node montages: full set,
    missing middle segment, no torso (facing known/unknown), distal-only,
    bilateral without torso. Documents the heading-correction gap, the
    shoulder range clamp, and which joints each montage can measure.
    Claude-Session: https://claude.ai/code/session_017CTRGRfDfk9z89VGSZuoUX
2026-09-25 Auto neutral window, elbow-hinge facing, plausibility checks, OpenSense path
    - calibrate: ignore a montage neutral window that was not still; auto-pick
    the first still window (quietest point of that stretch). Metrics and the
    viewer start at the neutral hold, dropping pre-protocol setup.
    - calibrate: without a torso node, recover the facing from the elbow
    hinge (minimize varus/valgus; flexion sign resolves the 180 deg branch),
    gated on real flexion and a clear minimum.
    - metrics: re-center unwrapped angles, flag physically implausible
    angles (range > 360, jumps, DOF limits), count reps as zig-zag swings
    grouped into bouts; elbow/wrist primary DOF is flexion.
    - metrics/viewer: spli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
2026-09-25 Assess default chain vs OpenSense; docs
    compare_paths.py also scores the elbow against the model's joint
    coordinates. SOLVER_COMPARISON.md records the synthetic ground-truth and
    real-capture results (default chain stays primary; OpenSense as QA).
    README lists the optional OpenSense stage; the checklist defines the
    N-pose as palms facing the thighs.
    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
2026-09-25 OpenSense path: model profiles, Thoracoscapular Shoulder Model support
    opensense_ik.py now drives either the Rajagopal 2016 model or the
    Thoracoscapular Shoulder Model (Seth et al. 2019; right arm, ISB-style
    glenohumeral coordinates), detected from the model file. Each profile maps
    our segments to bodies, sets the N-pose as the default pose (TSM:
    upright thorax, vertical forward-facing humerus solved numerically,
    forearm zero = thumb-forward from bone geometry), widens ranges, and now
    enforces them during IK (TSM ships with clamping off). Clavicle/scapula
    are held at rest (no node measures them). compare_paths.py can play the
    truth on Rajagopal while solving on another model, and adds the
    to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
2026-09-25 Thoracoscapular profile: unclamp wrapping shoulder angles; docs
    Plane of elevation and axial rotation must be free to wrap (clamped at
    +/-180 the realistic solves stuck and misfit); elevation starts at 0 to
    remove the mirror branch. Tool docs list both model profiles, the changes
    made to each published model, and setup for the Thoracoscapular model.
    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
2026-09-25 Thoracoscapular profile: leave all glenohumeral angles unclamped
    A clamped elevation traps the solve at its 0/180 deg poles (seen as the
    arm stuck overhead while it hung at the side). Downstream angles come
    from the solved bone orientation, so any equivalent glenohumeral triple
    is fine; elbow and pro/sup stay clamped.
    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
2026-09-25 Solver comparison with the Thoracoscapular Shoulder Model; methods draft
    SOLVER_COMPARISON.md now covers the default chain, OpenSense on Rajagopal
    and OpenSense on the Thoracoscapular Shoulder Model across full-arm,
    torso+upper-arm and upper-arm+forearm montages, the real capture, the
    raw-coordinate check (Rajagopal pro_sup is off ~6 deg without a torso
    node; TSM is not), a draft methods paragraph with references, and
    recommendations. Corrects the earlier note: reported (ISB, from the
    solved pose) angles agree across solvers; the difference is in raw
    model coordinates.
    Claude-Session: https://claude.ai/code/session_017CTRGRfDfk9z89VGSZ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
2026-09-26 Reconcile: sync on world angular-velocity vectors; timing bench
    Clock offsets are now found by cross-correlating each node's world-frame
    angular-velocity VECTORS instead of angular-speed magnitudes, trusted by
    peak distinctness. On synthetic sessions that run the real reconcile step
    (own clocks, ~8 Hz jittery sampling, 5 s STATIC gaps, strap wobble), speed
    sync paired a torso node's sync twist with an arm swing (35 s errors,
    44-126 deg angle errors); vector sync lands within ~0.1 deg of perfect
    sync on every montage and cuts upper-arm+forearm sync error 6 -> 2 ms.
    On the real capture it agrees with the old offset to 0.6 ms at higher
    confidence.
    timing_bench.py is the opensim-free harness be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
2026-09-26 Firmware: log every STATIC RV report (~1 Hz, was 0.2 Hz)
    STATIC_SAMPLE_INTERVAL_MS 5000 -> 1000 with a 250 ms slack so a report
    that lands a few ms early is not skipped. A torso node spends most of an
    arm session in STATIC and every shoulder angle is measured against it; at
    5 s its slow drift between samples was lost. timing_bench.py (now modelling
    the firmware schedule: 10 s to STATIC, <=0.5 s wake; motion-scaled strap
    wobble; independent random streams per setting) on torso + upper arm:
    shoulder axial rotation 6.3 -> 1.9 deg RMS, elevation 5.1 -> 2.5 deg,
    plane of elevation 9.5 -> 5.9 deg, for ~3.5% more samples. The RV already
    runs at ~1 Hz in STATIC, so the cost is only the extra 20-byte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
    [firmware.ino]
2026-09-26 Firmware: ACTIVE logs at exactly activeHz (scheduled slots + slack)
    The ACTIVE gate measured time since the last write, so it logged below
    the configured rate whenever RV reports didn't line up with the period:
    simulated at 10 Hz, 100 ms +/- 3 ms report jitter gave 6.9 Hz, a ~60 ms
    report stream 8.3 Hz (the 120 ms spacing seen in a real capture), 65 ms
    7.7 Hz. Each write now advances a schedule by exactly one period, a report
    may take its slot up to period/4 early, and the schedule restarts (no
    catch-up burst) after falling a period behind; signed differences keep it
    correct when a slot lies a few ms ahead and across the millis() rollover.
    10.00 Hz in every simulated case, throttle included.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
    [firmware.ino]
2026-09-26 Fix review findings: reused-calibration trim, ACTIVE resync after 24.8 days
    - metrics/viewer/OpenSense: trim to the neutral hold only when the
    calibration's window lies in THIS recording and is still there. A
    calibration reused from another session (verify -> reuse) carried that
    session's times and silently dropped the new session's first seconds;
    the OpenSense path now refuses such a calibration instead.
    - firmware ACTIVE gate: treat lastActiveSample == 0 (the transitions'
    resync marker) explicitly. With signed differences, once millis()
    passed 2^31 (~24.8 days) now - 0 read negative and ACTIVE stopped
    logging until the rollover.
    - reconcile: the windowed lag check (residual t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
    [firmware.ino]
2026-09-26 SOP: nodes may be removed between takes (e.g. charging)
    Removing a node between takes is allowed; the next take starts from the
    warm-up and neutral hold (as every take does), the node should go back the
    same way, and each mounting is analyzed with its own hold (offload in
    between, or --window), since the pipeline auto-detects the first hold in
    a log. The checklist's re-don note now covers taking a node out to charge.
    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
2026-09-26 End analysis at the closing hold; detect clock restarts in node logs
    - calibrate: find the closing hold - the last still window >= 5 s after
    the opening hold whose pose matches it (per-node gravity direction and
    adjacent-pair relative rotation within 10 deg, heading-independent like
    verify) - and record it in calibration.json. Metrics, the viewer and the
    OpenSense path analyze opening hold -> closing hold, so taking the nodes
    off (logged like any motion) no longer enters ROM/reps; without a
    closing hold the report says so and keeps to the end of the log. The
    real capture has none (its final still stretch is ~90 deg off the
    neutral pose: nodes on the table) and is correctly le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
2026-09-26 SOP + checklist: blocks and the charging checkpoint; closing hold required
    A session is a series of blocks, each ending at a charge: closing hold ->
    nodes onto the charger -> offload into one folder per block -> quick check
    -> erase -> re-mount. One block = one mounting = one analysis. The closing
    hold is now required (the analysis ends there). Accept/redo checks and
    troubleshooting cover the closing hold and clock restarts; the checklist's
    mental model, erase rationale, offload/analyze commands (per block folder)
    and manual-stage commands (metrics step) are brought up to date.
    Claude-Session: https://claude.ai/code/session_017CTRGRfDf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
2026-09-26 Docs sweep: vector sync, neutral/closing holds, blocks, rep bouts
    Bring every pipeline and sync doc in line with the current code:
    - README: vector clock sync, facing sources, analysis window, per-block
    quick start (SOP protocol, offload at the charging checkpoint).
    - METRICS.md: rep bouts, plausibility flags, wrist hand frame, facing
    from the elbow hinge, opening->closing-hold trim, new constants and
    output fields.
    - SETUP_AND_CALIBRATION_PLAN / MONTAGE_SCHEMA: window precedence (the
    montage window is only a hint), closing hold, per-mounting validity,
    sync gesture per block.
    - MULTINODE_SYNC_MATH/DESIGN/TESTING: world angular-velocity vector
    feature and its peak-distinctness rul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
2026-09-27 Review page: switch between the direct sensor view and model solves
    One review page now carries the session solved every way that was run:
    the direct sensor chain (with its raw/calibrated toggle) and OpenSense on
    each given model. A footer switch picks the solver and lands on the same
    moment, camera and graph; the angle graph's "compare solvers" overlay
    draws the other solves over the current one.
    - skeleton_viewer: --solver-dir (repeatable) bakes opensense_ik output
    folders into the page; scenes carry meta.solver; a model view has no
    raw mode and shows its fit in the header chip.
    - analyze_session: --opensense-model is repeatable; each model solves
    into opensense/<profile>/ and joins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
2026-10-01 Fix calibration on the torso + upper-arm capture; make model solves discoverable
    The first torso + upper-arm session looked wrong because calibration
    took a 2 s pause in the warm-up (0.07 rad/s) as the neutral hold, so
    every angle and the facing were 20-30 deg off; the closing hold was then
    also missed.
    - Neutral hold: the first still stretch lasting >= 3 s whose quietest
    2 s averages <= 0.04 rad/s (real holds: 0.004-0.017 rad/s for 9-42 s;
    warm-up pauses: 0.06-0.09 rad/s for 2-4 s). Old rule kept as fallback.
    - Closing hold: the last still window where every node is tilted as at
    neutral; a different arm rotation (or strap slip) is warned about
    instead of disqualifying the hold, whi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
2026-10-01 Protocol: sync gesture first, then the neutral hold
    Nodes power up and wake one by one, so a log starts with setup of any
    length, sometimes with still stretches as long as a hold. The SOP now
    runs wake-up -> sync gesture -> settle -> neutral hold -> task ->
    closing hold, and calibration uses the gesture as a landmark.
    - calibrate: sync-first (default) takes the first deliberate hold that
    starts within 20 s after a burst of shared fast motion (every node
    >= 1 rad/s for >= 3 s; real gestures ran ~2 rad/s). Still stretches
    before the gesture are never taken. hold-first keeps the previous
    rule for recordings made in the old order; a hold that ends right at
    the gesture triggers a hint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
2026-10-01 Simpler protocol: one-page recording card, no closing hold, block check
    The recording procedure is now five steps — strap on, sync movement,
    freeze, task, nodes off — on a one-page card (COLLECTION_SOP.md). The
    reasons, thresholds and troubleshooting moved to COLLECTION_REFERENCE.md.
    - No closing hold. calibrate_segments.find_session_end reads where the
    nodes came off: the log's final rest in a pose no body holds (a node
    tilted > 60 deg from the freeze) ends the analysis at the last pause
    within 10 s before it, else 5 s before it. A log ending in motion or
    still worn keeps its tail and says so; --end sets it by hand
    (calibrate and analyze_session). Old calibrations' closing wi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
2026-10-01 Fix the torso drawn face-down: ignore the enroll placeholder window
    A new torso + upper-arm capture showed the trunk tipped ~85 deg toward
    the ground. Calibration had used the montage's t_window_ms [1000, 4000]
    - the placeholder enroll writes into every montage - because it happened
    to be still: the torso node was lying on the table before strapping, so
    every later torso orientation was drawn relative to "lying flat".
    - The enroll placeholder is ignored (and enroll no longer writes it;
    examples and schema updated). A deliberate montage window still works.
    - Sync movement detection: every node moving (>= 0.4 rad/s) AND turning
    together (coherence of world angular-velocity vectors >= 0.8)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
2026-10-01 Make the analysis safe to change: sanity checks, regression library, CI
    - Block check: REDO when the torso reads > 30 deg tilted from its
    freeze for most of the session (calibrated in the wrong pose, e.g.
    the node still on the table: 82 deg on the face-down capture vs 4-5
    deg on good ones), and when a joint is outside physiological limits
    for > 25% of the session.
    - tools/regress.py: runs the whole pipeline on a library of real
    recordings and checks each against expectations a person confirmed
    (freeze, session end, verdict, sync, facing, ranges). `add` turns a
    recording into a case with pre-filled expectations to check and edit.
    Case files live in tools/regress_cases/ (in git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
2026-10-01 Review page: session timeline with draggable markers and a re-run command
    A Timeline strip (footer button) shows the WHOLE log - each node's
    angular speed in 200 ms bins - with the detected sync movement, the
    freeze (green band) and the session end (dashed line). Drag the freeze
    band (it snaps to the quietest 2 s within +-2 s) or the end line, and the
    strip builds the analysis command with --window / --end for Copy
    command. Correcting a detection needs no code.
    - skeleton_viewer: build_timeline bakes the overview into the direct
    sensor scene (model scenes reuse it); --rerun carries the command.
    The timeline shares the bottom slot with the angle graph, survives a
    solver switch (state i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
2026-10-01 Review page: tidy the footer into two rows
    The footer wrapped wherever it ran out of room (the scrubber dropped to
    its own line at 1300 px once Timeline was added). It is now two
    deliberate rows:
    - playback: Play, speed, the scrubber across the full width, the time;
    - controls in three groups that wrap as whole groups: panels (Metrics,
    Timeline) | camera (Front/Side/Top, Labels, Neutral pose) | how the
    pose is solved (Sensors / Shoulder / Rajagopal, Raw / Calibrated).
    Shorter labels: solver buttons drop "model" (full name stays in the
    tooltip and header chip), "Go to neutral pose" -> "Neutral pose". On
    phones the controls are one sideways-scrolling row and the frame counter
    is hidden: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
2026-10-21 Regression library: add the torso + upper arm session with a rebuilt montage
    The montage.json for this session was overwritten; it was rebuilt from the
    nodes' .seg.json headers. Expectations checked against the recording:
    freeze 30.5-48 s after the sync movement, end before the torso node lies
    flat at 107.3 s, elevation to ~132 deg.
    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
2026-10-21 Regression library: add an upper arm + forearm sync-first session
    Added from the capture folder alone (montage built from the nodes'
    .seg.json headers). Expectations checked against the recording: freeze
    30.5-42 s after the 18-30 s sync movement, end before the forearm node
    lies flat at 73.1 s, elbow flexion to ~124 deg. The elbow's -32 deg
    hyperextension (17% of the session) is recorded as a known NOTE.
    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
2026-10-21 Repository cleanup
    - multinode_test: retire the deprecated flag form (--offload, --erase,
    ...). It also fixes a bug: read-segments was missing from the
    subcommand list, so it fell through to the flag parser and failed. An
    old flag now names the subcommands instead. Usage text and header
    describe the tool as the BLE central it is.
    - calibrate_segments: drop the unused _pose_deviation; unused imports in
    multinode_test, timing_bench, opensense_feasibility; a placeholder-less
    f-string in analyze_session.
    - firmware.ino (comments only): the status characteristic is 6 bytes
    (segment tag + code), command 0x07 is listed, and the stale
    'Next: Phase 5 (data pipeline)' line is gone. REA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
2026-10-21 Fold the collection checklist into the reference
    COLLECTION_CHECKLIST.md overlapped the recording card and the reference.
    Its unique parts move into COLLECTION_REFERENCE.md:
    - laptop setup (bleak, BLE central platform, optional OpenSim) and where
    on each segment to strap the nodes, with the torso-forward reason, in
    section 3;
    - a new section 4, Setting up the nodes: what a node logs on its own,
    which steps connect over BLE, enroll / --reuse / read-segments, the
    UTF-8 note, and the occasional link check;
    - the checkpoint in section 5 gains the offload, analyze and erase
    details (holes, the folder's montage, binding table, Raw/Calibrated
    check, OpenSense solves, why erase after th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
2026-10-21 Standalone app with Python built in; pinned requirements.txt
    The standalone app (packaging/): PyInstaller bundles Python, numpy, bleak
    and every tool into one program per OS, so the lab machines need no
    Python. Double-clicked it starts the session app; from a terminal the
    same program runs the tools (HULC analyze …, HULC nodes offload …,
    HULC regress …, HULC selftest). OpenSim is not bundled.
    - The tools start each other as separate processes; every launch now
    goes through hulc_paths.tool_cmd, which inside the built app runs the
    app itself with --tool <module> (packaging/hulc_entry.py dispatches).
    The Timeline's re-run command names the app in that case.
    - Inside the built app t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
2026-10-21 Standalone app: the Windows download is one unzip
    The Windows artifact is now the HULC folder itself, so the download
    unzips straight to HULC\HULC.exe (it was a zip inside GitHub's zip).
    macOS and Linux keep the inner archive: a GitHub download zip drops the
    executable permission the .app and the Linux binary need. A version tag
    still attaches one archive per OS to the release (separate release-*
    artifacts). The README says how to download and open each build.
    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
2026-10-21 Rename the app and command to hulc-ms
    The HULC-MS app and its command are now hulc-ms everywhere:
    hulc-ms.py (the command and the standalone entry point), hulc-ms.bat /
    hulc-ms.command (the repository launchers; on Windows 'hulc-ms' works as
    typed), and the standalone build hulc-ms.exe / hulc-ms.app with
    artifacts hulc-ms-windows / -macos / -linux. Commands read
    'hulc-ms analyze …', 'hulc-ms nodes offload …'; the page is titled
    HULC-MS and the review page's re-run command uses hulc-ms.
    Unchanged on purpose: the internal module names and the data folders
    (~/HULC_sessions, ~/HULC), so sessions analysed with the earlier build
    stay where they are.
    Checked: hulc-ms selftest 10/10 and the fi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
2026-10-21 CI: show a failing standalone selftest as a check annotation
    The Windows build's selftest failed on c9b601b and the job log is only
    downloadable from GitHub's log host. On failure the step now writes the
    selftest summary, the last lines and the app log into one error
    annotation, readable from the checks API, and always prints the full
    output.
    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
2026-10-21 App: free the port on exit; selftest waits for Quit instead of racing it
    The Windows standalone selftest failed once (c9b601b) and passed on the
    next run with identical code. The app selftest's Quit check slept a
    fixed 0.5 s and then expected the server gone, but serve_forever only
    notices a shutdown on its next 0.5 s poll: measured, the server stops
    0.50 s after Quit, so the check raced it and a slow Windows runner lost.
    The selftest now waits for serve_forever to return (up to 10 s) and
    checks the port is free. The app also closes its listening socket on
    exit, so a relaunch right after Quit can take the same port.
    Claude-Session: htt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
2026-10-21 App: serialise session-state reads and writes (Windows failure)
    The Windows standalone selftest failed on cfd406c: GET
    /api/sessions/<id> answered 404 while the worker was rewriting that
    session's session.json, and the selftest crashed on the missing
    'status'. On Windows a file cannot be replaced while another thread has
    it open, and a reader can land on the moment of the replace, so the web
    server polling a session and the worker updating it collided; Linux and
    macOS allow both, hence Windows-only and intermittent. This is most
    likely what failed on c9b601b too (that run's output was not readable;
    the Quit-timing race fixed then was real but not shown to be the cause).
    - Store: one re-entr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
2026-10-21 Regression library: name the rebuilt-montage torso case _c
    2026-10-21_torso_upper-arm_recovered -> 2026-10-21_torso_upper-arm_c,
    following the _a / _b torso + upper arm cases. The recordings folder on
    the lab drive takes the same name.
    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
2026-10-22 README: download the standalone app from Releases
    v1.0 is released with the Windows, macOS and Linux builds attached, so
    the README points there first (public, no sign-in, no expiry) and gives
    the one-unzip steps for each release asset. CI artifacts stay mentioned
    for builds of unreleased work.
    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
2026-10-22 Docs: consolidate 20 documents into 6 for the handoff
    The documentation had grown to 20 files across README, docs/ and firmware/,
    mixing current reference with finished investigations and repeating the same
    facts (GATT table, pipeline stages, status) in several places. For a new
    owner of both the wearable and the software there was no single place to
    start.
    New structure, one document per question:
    - README.md: what it is, install, the hulc-ms commands, and a "start here" table
    - HANDOFF.md (new): state of things, open work (roadmap M/C/V items plus
    firmware F items), a first-week checklist, where things live (with
    TODO(handoff) placeholders for facts not in the repository)
    - docs/RECOR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
2026-10-22 Docs: add diagrams and use Canadian spelling
    Diagrams (Mermaid, rendered by GitHub; each checked to render without errors):
    - README: the two halves meeting at the capture folder
    - HANDOFF: status map (built / not validated / not started)
    - RECORDING: the block cycle, a block timeline with its thresholds, and a
    body figure showing where each node goes (docs/img/placement.svg, light
    and dark)
    - WEARABLE: node block diagram, the state machine, the offload sequence,
    and the flash layout
    - ANALYSIS: today vs target, the pipeline with its files (replacing both
    ASCII drawings), segments and joints, time offset vs mounting
    calibration, the change-and-release workflow
    - METHODS: the clock-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
2026-10-22 Add 3D printed case
2026-10-22 Docs: add hardware photos, app screenshots and the case design
    - WEARABLE §1.1 "What a node looks like": photos of the board stack (XIAO
    nRF52840 on the BNO086 breakout), the case with the 3.7 V 600 mAh LiPo,
    and the assembled node, with captions; §1.2 "The case" with a rendered
    preview of the STL. Battery and case added to the parts list.
    - Move the 3-D printed case to hardware/HULC_MS_Wearable_Case.stl.
    - Screenshots of the HULC-MS app (drop page, block check) and the review
    page (overview, neutral pose raw vs calibrated, Timeline, movement
    graph), taken from the 2026-10-21 upper-arm + forearm regression case.
    Only the images are committed, not the recording; the Timeline's c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
2026-10-26 Docs: rewrite METHODS.md in plainer language
    The technical reference was accurate but hard to follow: long sentences
    packed with code names, terms used before they were explained, and
    equations without a reading. It now reads more naturally while keeping
    every equation, number and finding:
    - each section opens with the idea in ordinary words, then gives the
    precise version, so the explanation flows into the math
    - equations are introduced or followed by what they mean, and symbols are
    named in words on first use
    - function and constant names moved out of the sentences into brackets,
    so nothing a developer needs is lost
    - a key-terms table at the top (quaternion, cross-correlation, lag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
2026-10-26 Docs: merge into an SOP and a technical reference
    Six documents become four, mirroring the two Word documents:
    - docs/SOP.md (new): the operating manual and the source of the SOP Word
    document. Building a node (parts, wiring, battery, case, with the
    photos), software setup and flashing, setting up the nodes, the
    pre-session checklist, recording a block, the charger routine,
    reviewing the analysis, data handling, troubleshooting, and appendices
    (commands, Python and the regression library, releasing, bench checks,
    older recordings). Replaces RECORDING.md and the hands-on parts of
    WEARABLE.md; operator details such as the binding-table check, montage
    overrides and why each blo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
2026-10-26 Docs: while charging, onboard flash, flash-limited block length
    Say "while charging" instead of "at the charger" (SOP chapter 7 renamed,
    links updated). The 2 MB QSPI flash is onboard the XIAO. Replace the
    90-minute battery guideline: the rate is dynamic, so a block lasts until
    the flash fills (~2.3 h of continuous movement, longer with rests), and
    the battery (~28 h on paper, unmeasured) is not the expected limit. The
    only iPhone offload was the early nRF Connect test. Shorten HANDOFF's
    overview to point at the README.
    Claude-Session: https://claude.ai/code/session_01BKeJN2eHhoZpsAPpsJFbwL
2026-10-26 SOP: two more "while charging" wordings
    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
2026-10-26 Docs: define a block as mount, collect, offload
    Drop "one charge" (the flash, not the battery, limits a block) and say
    what starts a new block.
    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
2026-10-26 Docs: nodes have no power switch; why each block re-syncs
    Nodes run whenever the battery is plugged in and stay powered while
    charging, so the clocks keep running between blocks. The time offset is
    still measured again in every block: the clocks drift tens of ppm apart
    and a node restarts if its battery runs flat. Replace "switch on" and
    "nodes off" in the block routine with "strap on" and "taken off".
    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
2026-10-27 Technical reference: explain what each pose solver does, and why OpenSense was evaluated
    Both solvers take each segment's calibrated orientation and produce joint
    angles: the default chain joint by joint, OpenSense by fitting a body model
    to all the sensors. Neither corrects a wrong orientation. Adds the three
    reasons OpenSense was evaluated: physiologically possible poses, a possible
    accuracy gain (only settled by lab validation), and a citable method.
    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
2026-10-27 SOP: align wording with the handover
    Define seconds (s) at first use; add the optional body model to the key
    terms; say why every block needs both the sync movement and the freeze;
    give the battery estimate in the checklist; note the Windows dongle
    exception; use "3D"; and redraw the block-cycle figure so it reads top
    to bottom.
    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
2026-10-27 SOP: offload when idle, command options, clearer timings; your edits
    Offload works whenever a node is idle; charging at the same time is the
    intended routine, not a requirement. SOP chapter 7 becomes "After the
    block" (links updated). Explain what enroll and offload do and list their
    options; state the step timings in words; enlarge Figure 9; note the narrow
    USB-C opening in the case. Carries the SOP edits made in the Word version.
    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
2026-10-27 SOP: prototype note for chapter 7, --count explained, larger figures; your edits
    Chapter 7 says it is the prototype-testing routine; deployment is not
    expected to send the nodes commands after every block. --count is the
    number of nodes, and Appendix A lists what each example value stands for.
    Figures 1 and 8 redrawn with larger text. Carries the edits made in the
    Word version (body/lid naming, fewer timing rows, Appendix E removed).
    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
2026-10-27 SOP: keep the operator chapters to operator steps
    Move the montage override, the UTF-8 note, the special cases within a block
    and the list of output files to Appendix B; mark Appendix D as developer
    material; explain the node's two identifiers (the label and the Bluetooth
    name); replace "rig" with "set of nodes" and spell out IMU.
    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
2026-10-27 SOP: explain every tweakable value; larger Figure 7; your edits
    Link check and erase say what --count and --duration mean; Appendix A's
    placeholder table covers --duration and --recursive, and the analyze
    options give their units; the regression test-case arguments are
    explained. Figure 7 (node placement) redrawn with larger labels.
    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
2026-10-27 Docs: keep only the README and the technical reference in the repository
    The SOP and the project handover are Word documents kept with the project
    files. docs/SOP.md and HANDOFF.md are removed; the SOP's developer
    appendices move into the technical reference (§9.7 running the stages by
    hand and fixing an analysis, §9.8 bench checks), and every link to the
    removed files, in the docs and in code comments, points there or to the
    Word documents.
    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
2026-10-27 Docs: render diagram text with one fixed font so labels are not clipped
    GitHub draws Mermaid labels in a different font from the one it measures
    them with, so long labels were cut off. Each diagram now sets a common
    font and plain SVG text labels, so the label is measured and drawn alike.
    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
2026-10-28 Docs: draw the diagrams as images so GitHub cannot cut off their labels
    Each diagram in the README and the technical reference is now a PNG in
    docs/img/diagrams/, with its Mermaid source kept in an HTML comment just
    above the image. docs/img/make_diagrams.cjs redraws them all after an
    edit; §9.2 says how.
    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
2026-10-28 Technical reference: tighten chapters 1-9
    Remove the pipeline diagram, review screenshot and module table from 1.2
    (the table now has a Step column; the modules move to 9.1). Shorten 3.3,
    explain the Euler sequence column in 3.4, reorganize 4.3 (UUID format,
    explained Time Info equation), clarify the IDLE reset in 4.6, and cut
    repeated or historical detail from chapters 4-8. Drop the three diagrams
    no longer used.
    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
2026-10-28 Technical reference: clearer Euler sequences, calibration and clock alignment
    Explain the Euler sequence step by step and name its source (3.4); label
    the firmware SECTION column (4.1); merge the time offset and calibration
    into one section (5.3, so the protocol is now 5.4); rewrite chapter 6 at
    the level of 6.2, with a smaller diagram, fewer formulas, a clearer
    confidence section and a sources table; add a diagram of the joint-angle
    chain (7.2).
    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
2026-10-28 Technical reference: restore the formulas with walkthroughs
    Bring back the angular-velocity, sub-sample lag, confidence and
    joint-angle chain formulas, each with its terms explained; say where the
    parabolic refinement is used; retitle 8.7 as the earlier partial-montage
    study and link it to the montage rule in 3.1.
    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
2026-10-28 Technical reference: walk through every metric formula in chapter 7
    Give each computation in 7.1-7.5 its formula with the terms explained and
    a worked example where it helps: unwrapping, the wrist frame, left/right
    mirroring, how the Euler angles are read and where they fail, the shoulder
    angles, range, velocity, repetitions, plausibility, speed, travel,
    elevation, SPARC, posture dwell, symmetry, activity asymmetry,
    coordination and trunk compensation.
    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
2026-10-28 Technical reference: walk through the pose-solver evidence in chapter 8
    Explain how OpenSense places its virtual sensors and solves the pose (the
    inverse-kinematics objective), the synthetic error model and the RMS error,
    the frame-by-frame difference, the fit residual and the fit-lost test, why
    the torso + upper arm montage fits exactly (counting measured numbers
    against free coordinates), and why a montage without the middle segment
    cannot be solved. Label the two runs in the full-arm table.
    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
2026-10-28 Technical reference: follow the pipeline, explain calibration, fix terms
    Reorder the chapters to follow the data: system, nodes, capture folder,
    clock alignment, montage, calibration and protocol, metrics, pose solver,
    changing the software. Move the mobile app's requirements and the bench
    checks to the nodes chapter, node identity to the capture folder, and the
    rotations primer to chapter 1. Add an introduction that states the
    document's audience and purpose, and a section on how calibration is
    computed (sync movement, freeze, mounting offset, facing, reuse). Fix the
    key terms, the meaning of an uncalibrated zero, the facing priority, and
    a few references. Update the section numbers that co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
2026-10-29 Adding .step cad case file
